revk/ESP32-ASR33/PCB/ASR33WAGO/README.md

# ASR33

Top
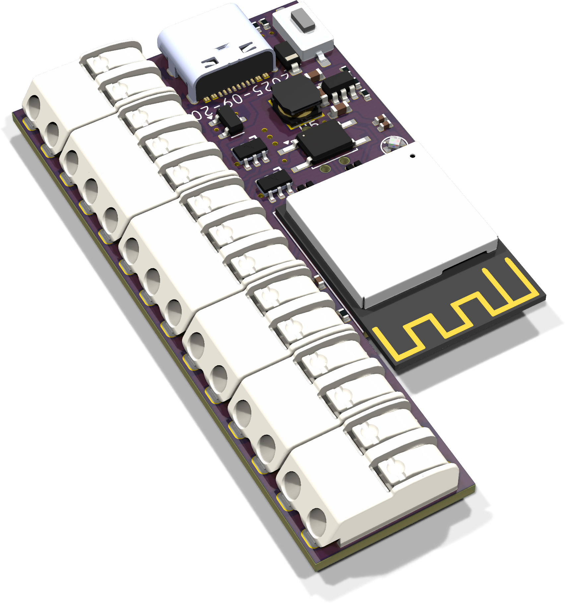
[picture p2: PCB/ASR33WAGO/ASR33-90.png]
Top rotated

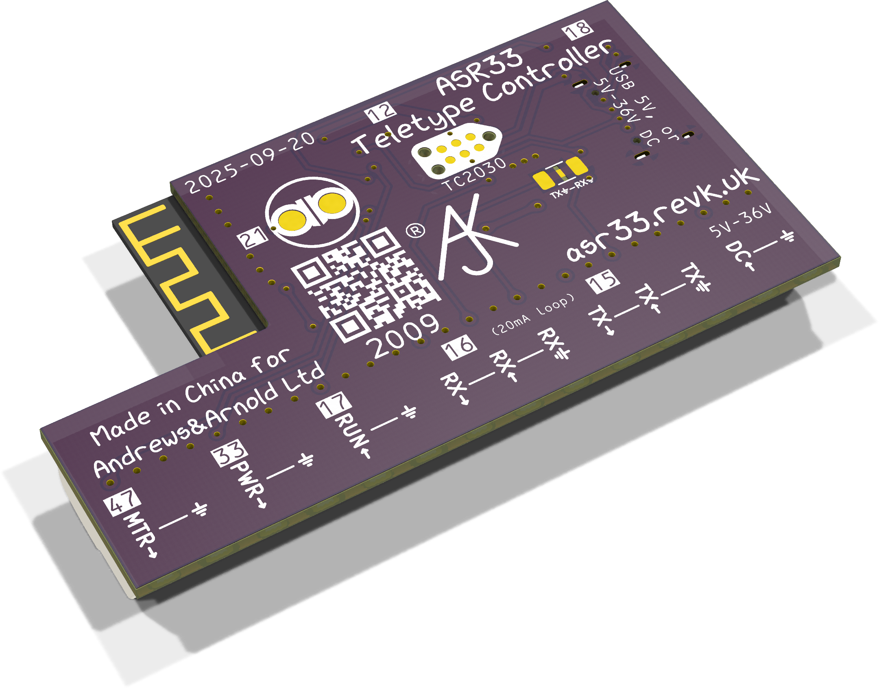
[picture p3: PCB/ASR33WAGO/ASR33-bottom.png]
Bottom
