revk/ESP32-ASR33/PCB/PCBOld/README.md

# ASR33Old

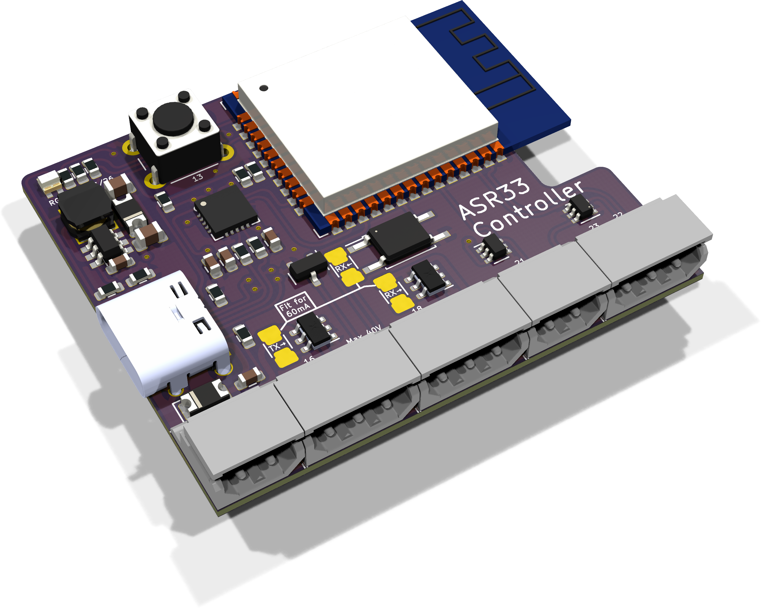
[picture p4: PCB/PCBOld/ASR33Old.png]
Top

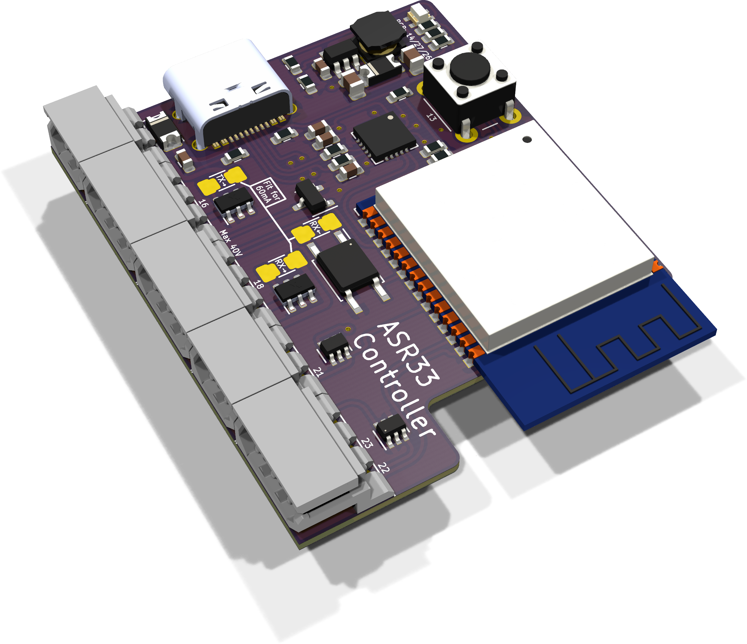
[picture p5: PCB/PCBOld/ASR33Old-90.png]
Top rotated

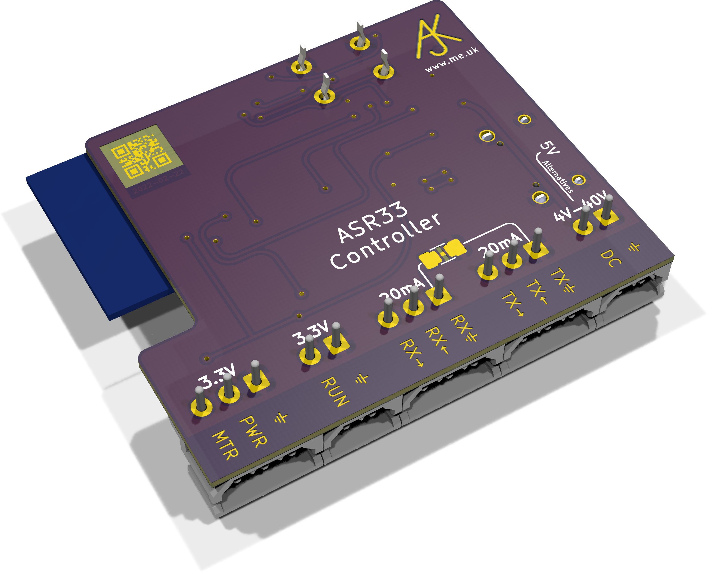
[picture p6: PCB/PCBOld/ASR33Old-bottom.png]
Bottom
