revk/ESP32-ASR33/PCB/ASR33/ASR33-90.png

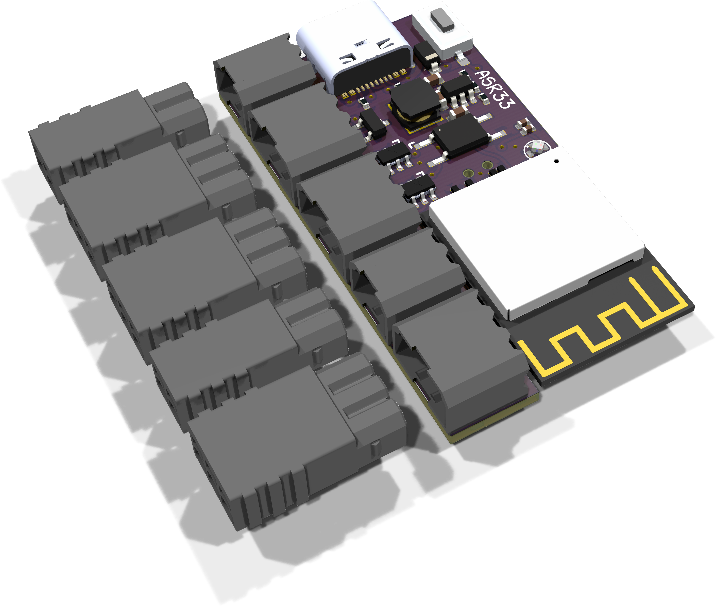
PCB/ASR33/ASR33-90.png
