revk/ESP32-ASR33/PCB/ASR33/ASR33-panel.png

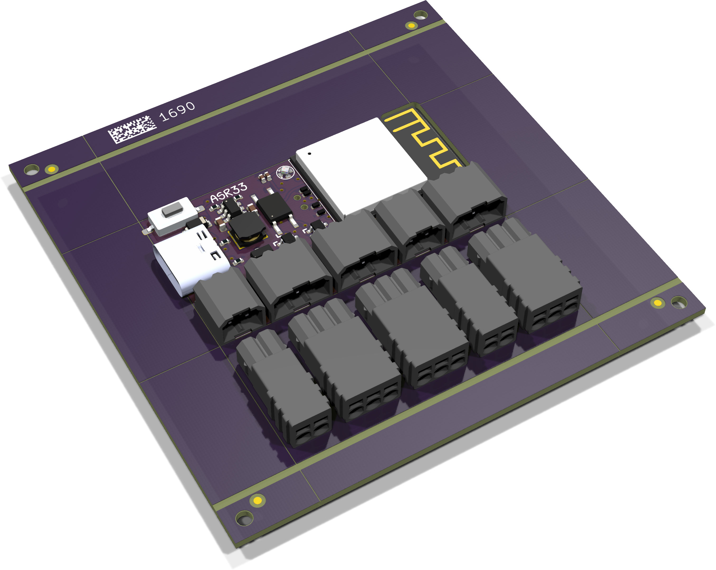
PCB/ASR33/ASR33-panel.png
