revk/ESP32-ASR33/PCB/ASR33WAGO/ASR33-panel-bottom.png

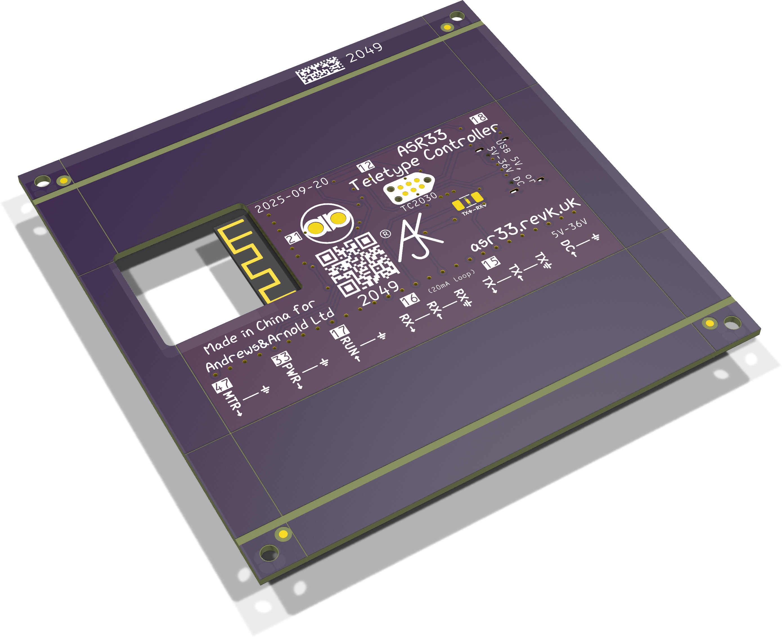
PCB/ASR33WAGO/ASR33-panel-bottom.png
