revk/ESP32-ASR33/PCB/ASR33WAGO/ASR33T.stl

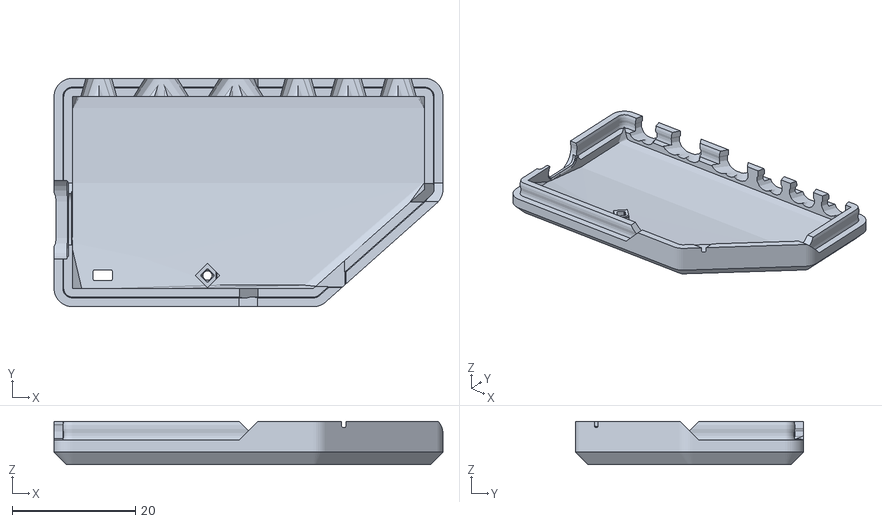
[picture p13: CAD file, 2025-09-20]
PCB/ASR33WAGO/ASR33T.stl
63.0 x 37.0 x 6.99
