revk/ESP32-ASR33/PCB/ASR33WAGO/ASR33B.stl

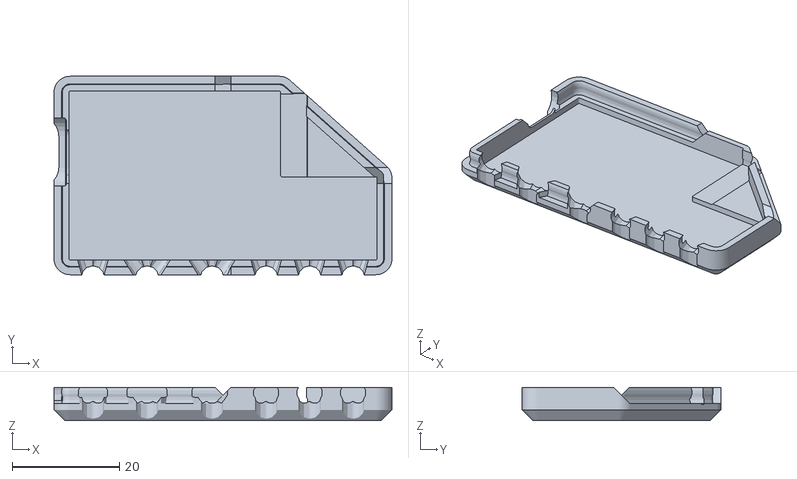
[picture p14: CAD file, 2025-09-20]
PCB/ASR33WAGO/ASR33B.stl
63.0 x 37.0 x 6.20
