revk/ESP32-ASR33/PCB/ASR33WAGO/ASR33B.scad

// Generated case design for ASR33WAGO/ASR33.kicad_pcb
// By https://github.com/revk/PCBCase
// Generated 2025-09-20 13:49:31
// title:	ASR33 driver
// rev:	1
// comment:	www.me.uk
// comment:	@TheRealRevK
//

// Globals
margin=0.250000;
lip=3.000000;
lipa=0;
lipt=2;
casebottom=2.000000;
casetop=7.000000;
casewall=3.000000;
fit=0.000000;
snap=0.150000;
edge=2.000000;
pcbthickness=1.200000;
function pcbthickness()=1.200000;
nohull=false;
hullcap=1.000000;
hulledge=1.000000;
useredge=false;
datex=0.000000;
datey=0.000000;
datet=0.500000;
dateh=3.000000;
datea=0;
date="2025-09-20";
datef="OCRB";
spacing=73.000000;
pcbwidth=57.000000;
function pcbwidth()=57.000000;
pcblength=31.000000;
function pcblength()=31.000000;
originx=100.500000;
originy=100.500000;

module outline(h=pcbthickness,r=0){linear_extrude(height=h)offset(r=r)polygon(points=[[10.500000,15.500000],[-28.500000,15.500000],[-28.500000,-15.500000],[28.500000,-15.500000],[28.500000,-0.500000],[11.000000,-0.500000],[10.808658,-0.461939],[10.646447,-0.353553],[10.538061,-0.191342],[10.500000,0.000000]],paths=[[0,1,2,3,4,5,6,7,8,9]]);}

module pcb(h=pcbthickness,r=0){linear_extrude(height=h)offset(r=r)polygon(points=[[10.500000,15.500000],[-28.500000,15.500000],[-28.500000,-15.500000],[28.500000,-15.500000],[28.500000,-0.500000],[11.000000,-0.500000],[10.808658,-0.461939],[10.646447,-0.353553],[10.538061,-0.191342],[10.500000,0.000000]],paths=[[0,1,2,3,4,5,6,7,8,9]]);}
module U4(){translate([-7.800000,1.300000,1.200000])children();}
module part_U4(part=true,hole=false,block=false)
{
// Missing model U4.1 SOT457
};
module V4(){translate([28.500000,0.500000,1.200000])rotate([0,0,90.000000])children();}
module part_V4(part=true,hole=false,block=false)
{
};
module R1(){translate([-15.500000,14.500000,1.200000])children();}
module part_R1(part=true,hole=false,block=false)
{
translate([-15.500000,14.500000,1.200000])m0(part,hole,block,casetop); // RevK:R_0402_ R_0402_1005Metric (back)
};
module C12(){translate([-15.500000,10.600000,1.200000])children();}
module part_C12(part=true,hole=false,block=false)
{
translate([-15.500000,10.600000,1.200000])m1(part,hole,block,casetop); // RevK:C_0603_ C_0603_1608Metric (back)
};
module C11(){translate([4.000000,-0.900000,1.200000])rotate([0,0,180.000000])children();}
module part_C11(part=true,hole=false,block=false)
{
translate([4.000000,-0.900000,1.200000])rotate([0,0,180.000000])m2(part,hole,block,casetop); // RevK:C_0402 C_0402_1005Metric (back)
};
module U5(){translate([-10.000000,7.850000,1.200000])rotate([0,0,90.000000])children();}
module part_U5(part=true,hole=false,block=false)
{
translate([-10.000000,7.850000,1.200000])rotate([0,0,90.000000])m3(part,hole,block,casetop); // U5 (back)
};
module J5(){translate([24.250000,-7.500000,1.200000])rotate([0,0,90.000000])children();}
module part_J5(part=true,hole=false,block=false)
{
translate([24.250000,-7.500000,1.200000])rotate([0,0,90.000000])m4(part,hole,block,casetop,452); // J5 (back)
};
module U3(){translate([-12.400000,1.300000,1.200000])children();}
module part_U3(part=true,hole=false,block=false)
{
// Missing model U3.1 SOT457
};
module J7(){translate([-22.000000,4.400000,1.200000])rotate([0,0,-90.000000])children();}
module part_J7(part=true,hole=false,block=false)
{
translate([-22.000000,4.400000,1.200000])rotate([0,0,-90.000000])translate([0.000000,-2.400000,0.000000])rotate([90.000000,-0.000000,-0.000000])m5(part,hole,block,casetop); // RevK:USB-C-Socket-H CSP-USC16-TR (back)
};
module R8(){translate([-27.000000,10.000000,1.200000])children();}
module part_R8(part=true,hole=false,block=false)
{
translate([-27.000000,10.000000,1.200000])m0(part,hole,block,casetop); // RevK:R_0402_ R_0402_1005Metric (back)
};
module D1(){translate([-21.500000,10.400000,1.200000])rotate([0,0,180.000000])children();}
module part_D1(part=true,hole=false,block=false)
{
translate([-21.500000,10.400000,1.200000])rotate([0,0,180.000000])m6(part,hole,block,casetop); // D1 (back)
};
module V3(){translate([-28.500000,0.500000,1.200000])rotate([0,0,90.000000])children();}
module part_V3(part=true,hole=false,block=false)
{
};
module D7(){translate([-6.000000,9.200000,1.200000])rotate([0,0,180.000000])children();}
module part_D7(part=true,hole=false,block=false)
{
translate([-6.000000,9.200000,1.200000])rotate([0,0,180.000000])m7(part,hole,block,casetop); // D7 (back)
};
module PCB1(){translate([-0.500000,0.500000,1.200000])children();}
module part_PCB1(part=true,hole=false,block=false)
{
};
module C10(){translate([-10.100000,14.000000,1.200000])rotate([0,0,90.000000])children();}
module part_C10(part=true,hole=false,block=false)
{
translate([-10.100000,14.000000,1.200000])rotate([0,0,90.000000])m2(part,hole,block,casetop); // RevK:C_0402 C_0402_1005Metric (back)
};
module R7(){translate([-27.000000,11.000000,1.200000])rotate([0,0,180.000000])children();}
module part_R7(part=true,hole=false,block=false)
{
translate([-27.000000,11.000000,1.200000])rotate([0,0,180.000000])m0(part,hole,block,casetop); // RevK:R_0402_ R_0402_1005Metric (back)
};
module R2(){translate([-13.700000,14.500000,1.200000])children();}
module part_R2(part=true,hole=false,block=false)
{
translate([-13.700000,14.500000,1.200000])m0(part,hole,block,casetop); // RevK:R_0402_ R_0402_1005Metric (back)
};
module U1(){translate([-15.500000,12.600000,1.200000])children();}
module part_U1(part=true,hole=false,block=false)
{
translate([-15.500000,12.600000,1.200000])m8(part,hole,block,casetop); // RevK:SOT-23-6-MD8942 SOT-23-6 (back)
};
module U8(){translate([2.750000,7.500000,1.200000])rotate([0,0,-90.000000])children();}
module part_U8(part=true,hole=false,block=false)
{
translate([2.750000,7.500000,1.200000])rotate([0,0,-90.000000])m9(part,hole,block,casetop); // U8 (back)
};
module L2(){translate([-15.500000,8.000000,1.200000])children();}
module part_L2(part=true,hole=false,block=false)
{
translate([-15.500000,8.000000,1.200000])rotate([-0.000000,-0.000000,-90.000000])m10(part,hole,block,casetop); // RevK:L_4x4_ TYA4020 (back)
};
module J9(){translate([-24.250000,-7.500000,1.200000])rotate([0,0,90.000000])children();}
module part_J9(part=true,hole=false,block=false)
{
translate([-24.250000,-7.500000,1.200000])rotate([0,0,90.000000])m4(part,hole,block,casetop,452); // J5 (back)
};
module R3(){translate([-17.300000,14.500000,1.200000])children();}
module part_R3(part=true,hole=false,block=false)
{
translate([-17.300000,14.500000,1.200000])m0(part,hole,block,casetop); // RevK:R_0402_ R_0402_1005Metric (back)
};
module Q1(){translate([-16.750000,1.537500,1.200000])rotate([0,0,90.000000])children();}
module part_Q1(part=true,hole=false,block=false)
{
translate([-16.750000,1.537500,1.200000])rotate([0,0,90.000000])m11(part,hole,block,casetop); // Q1 (back)
};
module J1(){translate([-14.150000,-7.500000,1.200000])rotate([0,0,90.000000])children();}
module part_J1(part=true,hole=false,block=false)
{
translate([-14.150000,-7.500000,1.200000])rotate([0,0,90.000000])m4(part,hole,block,casetop,453); // J5 (back)
};
module V1(){translate([-0.500000,15.500000,1.200000])children();}
module part_V1(part=true,hole=false,block=false)
{
};
module D2(){translate([-5.975000,8.350000,1.200000])rotate([0,0,180.000000])children();}
module part_D2(part=true,hole=false,block=false)
{
translate([-5.975000,8.350000,1.200000])rotate([0,0,180.000000])m7(part,hole,block,casetop); // D7 (back)
};
module D6(){translate([-6.000000,4.100000,1.200000])rotate([0,0,180.000000])children();}
module part_D6(part=true,hole=false,block=false)
{
translate([-6.000000,4.100000,1.200000])rotate([0,0,180.000000])m7(part,hole,block,casetop); // D7 (back)
};
module J2(){translate([-2.050000,-7.500000,1.200000])rotate([0,0,90.000000])children();}
module part_J2(part=true,hole=false,block=false)
{
translate([-2.050000,-7.500000,1.200000])rotate([0,0,90.000000])m4(part,hole,block,casetop,453); // J5 (back)
};
module R13(){translate([8.200000,-0.900000,1.200000])children();}
module part_R13(part=true,hole=false,block=false)
{
translate([8.200000,-0.900000,1.200000])m0(part,hole,block,casetop); // RevK:R_0402_ R_0402_1005Metric (back)
};
module V2(){translate([-0.500000,-15.500000,1.200000])rotate([0,0,180.000000])children();}
module part_V2(part=true,hole=false,block=false)
{
};
module C9(){translate([-9.200000,14.000000,1.200000])rotate([0,0,90.000000])children();}
module part_C9(part=true,hole=false,block=false)
{
translate([-9.200000,14.000000,1.200000])rotate([0,0,90.000000])m2(part,hole,block,casetop); // RevK:C_0402 C_0402_1005Metric (back)
};
module C8(){translate([-13.000000,11.300000,1.200000])rotate([0,0,90.000000])children();}
module part_C8(part=true,hole=false,block=false)
{
translate([-13.000000,11.300000,1.200000])rotate([0,0,90.000000])m1(part,hole,block,casetop); // RevK:C_0603_ C_0603_1608Metric (back)
};
module D4(){translate([-6.650000,13.450000,1.200000])rotate([0,0,45.000000])children();}
module part_D4(part=true,hole=false,block=false)
{
translate([-6.650000,13.450000,1.200000])rotate([0,0,45.000000])m12(part,hole,block,casetop); // RevK:SMD1010+ SMD1010 (back)
};
module SW1(){translate([-23.600000,13.400000,1.200000])children();}
module part_SW1(part=true,hole=false,block=false)
{
translate([-23.600000,13.400000,1.200000])m13(part,hole,block,casetop); // SW1 (back)
};
module J3(){translate([8.050000,-7.500000,1.200000])rotate([0,0,90.000000])children();}
module part_J3(part=true,hole=false,block=false)
{
translate([8.050000,-7.500000,1.200000])rotate([0,0,90.000000])m4(part,hole,block,casetop,452); // J5 (back)
};
module D3(){translate([-6.000000,3.200000,1.200000])rotate([0,0,180.000000])children();}
module part_D3(part=true,hole=false,block=false)
{
translate([-6.000000,3.200000,1.200000])rotate([0,0,180.000000])m7(part,hole,block,casetop); // D7 (back)
};
module J4(){translate([16.150000,-7.500000,1.200000])rotate([0,0,90.000000])children();}
module part_J4(part=true,hole=false,block=false)
{
translate([16.150000,-7.500000,1.200000])rotate([0,0,90.000000])m4(part,hole,block,casetop,452); // J5 (back)
};
module C1(){translate([-18.000000,11.300000,1.200000])rotate([0,0,90.000000])children();}
module part_C1(part=true,hole=false,block=false)
{
translate([-18.000000,11.300000,1.200000])rotate([0,0,90.000000])m1(part,hole,block,casetop); // RevK:C_0603_ C_0603_1608Metric (back)
};
// Parts to go on PCB (top)
module parts_top(part=false,hole=false,block=false){
part_U4(part,hole,block);
part_V4(part,hole,block);
part_R1(part,hole,block);
part_C12(part,hole,block);
part_C11(part,hole,block);
part_U5(part,hole,block);
part_J5(part,hole,block);
part_U3(part,hole,block);
part_J7(part,hole,block);
part_R8(part,hole,block);
part_D1(part,hole,block);
part_V3(part,hole,block);
part_D7(part,hole,block);
part_PCB1(part,hole,block);
part_C10(part,hole,block);
part_R7(part,hole,block);
part_R2(part,hole,block);
part_U1(part,hole,block);
part_U8(part,hole,block);
part_L2(part,hole,block);
part_J9(part,hole,block);
part_R3(part,hole,block);
part_Q1(part,hole,block);
part_J1(part,hole,block);
part_V1(part,hole,block);
part_D2(part,hole,block);
part_D6(part,hole,block);
part_J2(part,hole,block);
part_R13(part,hole,block);
part_V2(part,hole,block);
part_C9(part,hole,block);
part_C8(part,hole,block);
part_D4(part,hole,block);
part_SW1(part,hole,block);
part_J3(part,hole,block);
part_D3(part,hole,block);
part_J4(part,hole,block);
part_C1(part,hole,block);
}

parts_top=15;
module J8(){translate([-10.000000,7.485000,0.000000])rotate([180,0,0])children();}
module part_J8(part=true,hole=false,block=false)
{
};
module JP1(){translate([-15.200000,1.600000,0.000000])rotate([180,0,0])children();}
module part_JP1(part=true,hole=false,block=false)
{
};
module J6(){translate([2.750000,7.500000,0.000000])rotate([0,0,180.000000])rotate([180,0,0])children();}
module part_J6(part=true,hole=false,block=false)
{
};
// Parts to go on PCB (bottom)
module parts_bottom(part=false,hole=false,block=false){
part_J8(part,hole,block);
part_JP1(part,hole,block);
part_J6(part,hole,block);
}

parts_bottom=0;
module b(cx,cy,z,w,l,h){translate([cx-w/2,cy-l/2,z])cube([w,l,h]);}
module m0(part=false,hole=false,block=false,height)
{ // RevK:R_0402_ R_0402_1005Metric
// 0402 Resistor
if(part)
{
	b(0,0,0,1.5,0.65,0.2); // Pad size
	b(0,0,0,1.0,0.5,0.5); // Chip
}
}

module m1(part=false,hole=false,block=false,height)
{ // RevK:C_0603_ C_0603_1608Metric
// 0603 Capacitor
if(part)
{
	b(0,0,0,1.6,0.8,1); // Chip
	b(0,0,0,1.6,0.95,0.2); // Pad size
}
}

module m2(part=false,hole=false,block=false,height)
{ // RevK:C_0402 C_0402_1005Metric
// 0402 Capacitor
if(part)
{
	b(0,0,0,1.0,0.5,1); // Chip
	b(0,0,0,1.5,0.65,0.2); // Pad size
}
}

module m3(part=false,hole=false,block=false,height)
{ // U5
// SO-4_4.4x3.6mm_P2.54mm 
if(part)
{
	b(0,0,0,4.55,3.75,2.1); // Part
	b(0,0,0,7.0,3,1.5); // Pins
}
}

module m4(part=false,hole=false,block=false,height,N=0)
{ // J5
// WAGO-2060-45x-998-404
n=N%10; // 45x
if(part)
{
	translate([-0.9,0,0])hull()
	{
		b(0,0,0,12.7,n*4-0.1,1);
		translate([0.8,0,0])b(0,0,0,11.1,n*4-0.1,4.5);
	}
	for(p=[0:n-1])hull()
    {
        translate([-6,-4*(n-1)/2+p*4,2])sphere(d=3,$fn=12);
        translate([-11.510,0,2])sphere(d=4,$fn=12);
    }
}
if(hole)
{
    hull()
    {
        translate([-11.510,0,2])sphere(d=4,$fn=12);
        translate([-11.510,0,-height])sphere(d=4,$fn=12);
    }
    hull()
    {
        translate([-11.510,0,2])sphere(d=4,$fn=12);
        translate([-50,0,2])sphere(d=4,$fn=12);
    }
}
}

module m5(part=false,hole=false,block=false,height)
{ // RevK:USB-C-Socket-H CSP-USC16-TR
// USB connector
rotate([-90,0,0])translate([-4.47,-3.84,0])
{
	if(part)
	{
		b(4.47,7,0,7,2,0.2);	// Pads
		translate([1.63,-0.2,1.63])
		rotate([-90,0,0])
		hull()
		{
			cylinder(d=3.26,h=7.55,$fn=24);
			translate([5.68,0,0])
			cylinder(d=3.26,h=7.55,$fn=24);
		}
		translate([0,6.2501,0])cube([8.94,1.1,1.6301]);
		translate([0,1.7,0])cube([8.94,1.6,1.6301]);
	}
	if(hole)
		translate([1.63,-21.2-1,1.63])
		rotate([-90,0,0])
	{
		// Plug
		hull()
		{
			cylinder(d=2.5,h=24,$fn=24);
			translate([5.68,0,0])
			cylinder(d=2.5,h=24,$fn=24);
		}
		hull()
		{
			cylinder(d=7,h=21,$fn=24);
			translate([5.68,0,0])
			cylinder(d=7,h=21,$fn=24);
		}
		translate([2.84,0,-100])
			cylinder(d=5,h=100,$fn=24);
	}
}
}

module m6(part=false,hole=false,block=false,height)
{ // D1
// SOD-123 Diode
if(part)
{
	b(0,0,0,2.85,1.8,1.35); // part
	b(0,0,0,4.2,1.2,0.7); // pads
}
}

module m7(part=false,hole=false,block=false,height)
{ // D7
// DFN1006-2L
if(part)
{
	b(0,0,0,1.0,0.6,0.45); // Chip
}
}

module m8(part=false,hole=false,block=false,height)
{ // RevK:SOT-23-6-MD8942 SOT-23-6
// SOT-23-6
if(part)
{
	b(0,0,0,1.726,3.026,1.2); // Part
	b(0,0,0,3.6,2.5,0.5); // Pins
}
}

module m9(part=false,hole=false,block=false,height)
{ // U8
// ESP32-S3-MINI-1
translate([-15.4/2,-15.45/2,0])
{
	if(part)
	{
		cube([15.4,20.5,0.8]);
		translate([0.7,0.5,0])cube([14,13.55,2.4]);
		cube([15.4,20.5,0.8]);
	}
}
}

module m10(part=false,hole=false,block=false,height)
{ // RevK:L_4x4_ TYA4020
// 4x4 Inductor
if(part)
{
	b(0,0,0,4,4,3);
}
}

module m11(part=false,hole=false,block=false,height)
{ // Q1
// SOT-23
if(part)
{
	b(0,0,0,1.4,3.0,1.1); // Body
	b(-0.9375,-0.95,0,1.475,0.6,0.5); // Pad
	b(-0.9375,0.95,0,1.475,0.6,0.5); // Pad
	b(0.9375,0,0,1.475,0.6,0.5); // Pad
}
}

module m12(part=false,hole=false,block=false,height)
{ // RevK:SMD1010+ SMD1010
// 1x1mm LED
if(part)
{
        b(0,0,0,1.2,1.2,.8);
}
if(hole)
{
        hull()
        {
                b(0,0,.8,1.2,1.2,1);
                translate([0,0,height])cylinder(d=1.001,h=0.001,$fn=16);
        }
}
if(block)
{
        hull()
        {
                b(0,0,.8,2.8,2.8,1);
                translate([0,0,height])cylinder(d=2,h=1,$fn=16);
        }
}
}

module m13(part=false,hole=false,block=false,height)
{ // SW1
if(part)
{
	b(0,0,0,6.1,3.6,1.8);
	b(0,0,0,7.9,0.6,0.5);
}
if(hole)
{
	b(0,0,0,2.65,1.25,height+1);
}
}

// Generate PCB casework

height=casebottom+pcbthickness+casetop;
$fn=48;

module pyramid()
{ // A pyramid
 polyhedron(points=[[0,0,0],[-height,-height,height],[-height,height,height],[height,height,height],[height,-height,height]],faces=[[0,1,2],[0,2,3],[0,3,4],[0,4,1],[4,3,2,1]]);
}


module pcb_hulled(h=pcbthickness,r=0)
{ // PCB shape for case
	if(useredge)outline(h,r);
	else hull()outline(h,r);
}

module solid_case(d=0)
{ // The case wall
	hull()
        {
                translate([0,0,-casebottom])pcb_hulled(height,casewall-edge);
                translate([0,0,edge-casebottom])pcb_hulled(height-edge*2,casewall);
        }
}

module preview()
{
	pcb();
	color("#0f0")parts_top(part=true);
	color("#0f0")parts_bottom(part=true);
	color("#f00")parts_top(hole=true);
	color("#f00")parts_bottom(hole=true);
	color("#00f8")parts_top(block=true);
	color("#00f8")parts_bottom(block=true);
}

module top_half(fit=0)
{
	difference()
	{
		translate([-casebottom-100,-casewall-100,pcbthickness+0.01]) cube([pcbwidth+casewall*2+200,pcblength+casewall*2+200,height]);
		translate([0,0,pcbthickness])
        	{
			snape=lip/5;
			snaph=(lip-snape*2)/3;
			if(lipt==1)rotate(lipa)hull()
			{
				translate([0,-pcblength,lip/2])cube([0.001,pcblength*2,0.001]);
				translate([-lip/2,-pcblength,0])cube([lip,pcblength*2,0.001]);
			} else if(lipt==2)for(a=[0,90,180,270])rotate(a+lipa)hull()
			{
				translate([0,-pcblength-pcbwidth,lip/2])cube([0.001,pcblength*2+pcbwidth*2,0.001]);
				translate([-lip/2,-pcblength-pcbwidth,0])cube([lip,pcblength*2+pcbwidth*2,0.001]);
			}
            		difference()
            		{
                		pcb_hulled(lip,casewall);
				if(snap)
                        	{
					hull()
					{
						pcb_hulled(0.1,casewall/2-snap/2+fit);
						translate([0,0,snape])pcb_hulled(snaph,casewall/2+snap/2+fit);
						translate([0,0,lip-snape-snaph])pcb_hulled(0.1,casewall/2-snap/2+fit);
					}
					translate([0,0,lip-snape-snaph])pcb_hulled(snaph,casewall/2-snap/2+fit);
					hull()
					{
						translate([0,0,lip-snape])pcb_hulled(0.1,casewall/2-snap/2+fit);
						translate([0,0,lip])pcb_hulled(0.1,casewall/2+snap/2+fit);
					}
                        	}
				else pcb_hulled(lip,casewall/2+fit);
				if(lipt==0)translate([-pcbwidth,-pcblength,0])cube([pcbwidth*2,pcblength*2,lip]);
				else if(lipt==1) rotate(lipa)translate([0,-pcblength,0])hull()
				{
					translate([lip/2,0,0])cube([pcbwidth,pcblength*2,lip]);
					translate([-lip/2,0,lip])cube([pcbwidth,pcblength*2,lip]);
				}
				else if(lipt==2)for(a=[0,180])rotate(a+lipa)hull()
                		{
                            		translate([lip/2,lip/2,0])cube([pcbwidth+pcblength,pcbwidth+pcblength,lip]);
                            		translate([-lip/2,-lip/2,lip])cube([pcbwidth+pcblength,pcbwidth+pcblength,lip]);
                		}
            		}
            		difference()
            		{
				if(snap)
                        	{
					hull()
					{
						translate([0,0,-0.1])pcb_hulled(0.1,casewall/2+snap/2-fit);
						translate([0,0,snape-0.1])pcb_hulled(0.1,casewall/2-snap/2-fit);
					}
					translate([0,0,snape])pcb_hulled(snaph,casewall/2-snap/2-fit);
					hull()
					{
						translate([0,0,snape+snaph])pcb_hulled(0.1,casewall/2-snap/2-fit);
						translate([0,0,lip-snape-snaph])pcb_hulled(snaph,casewall/2+snap/2-fit);
						translate([0,0,lip-0.1])pcb_hulled(0.1,casewall/2-snap/2-fit);
					}
                        	}
				else pcb_hulled(lip,casewall/2-fit);
				if(lipt==1)rotate(lipa+180)translate([0,-pcblength,0])hull()
				{
					translate([lip/2,0,0])cube([pcbwidth,pcblength*2,lip+0.1]);
					translate([-lip/2,0,lip])cube([pcbwidth,pcblength*2,lip+0.1]);
				}
				else if(lipt==2)for(a=[90,270])rotate(a+lipa)hull()
                		{
                            		translate([lip/2,lip/2,0])cube([pcbwidth+pcblength,pcbwidth+pcblength,lip]);
                            		translate([-lip/2,-lip/2,lip])cube([pcbwidth+pcblength,pcbwidth+pcblength,lip]);
                		}
			}
            	}
		minkowski()
                {
                	union()
                	{
                		parts_top(part=true,hole=true);
                		parts_bottom(part=true,hole=true);
                	}
                	translate([-0.01,-0.01,-height])cube([0.02,0.02,height]);
                }
        }
	minkowski()
        {
        	union()
                {
                	parts_top(part=true,hole=true);
                	parts_bottom(part=true,hole=true);
                }
                translate([-0.01,-0.01,0])cube([0.02,0.02,height]);
        }
}

module case_wall()
{
	difference()
	{
		solid_case();
		translate([0,0,-height])pcb_hulled(height*2,0.02);
	}
}

module top_side_hole()
{
	difference()
	{
		intersection()
		{
			parts_top(hole=true);
			case_wall();
		}
		translate([0,0,-casebottom])pcb_hulled(height,casewall);
	}
}

module bottom_side_hole()
{
	difference()
	{
		intersection()
		{
			parts_bottom(hole=true);
			case_wall();
		}
		translate([0,0,edge-casebottom])pcb_hulled(height-edge*2,casewall);
	}
}

module parts_space()
{
	minkowski()
	{
		union()
		{
			parts_top(part=true,hole=true);
			parts_bottom(part=true,hole=true);
		}
		sphere(r=margin,$fn=6);
	}
}

module top_cut(fit=0)
{
	difference()
	{
		top_half(fit);
		if(parts_top)difference()
		{
			minkowski()
			{ // Penetrating side holes
				top_side_hole();
				rotate([180,0,0])
				pyramid();
			}
			minkowski()
			{
				top_side_hole();
				rotate([0,0,45])cylinder(r=margin,h=height,$fn=4);
			}
		}
	}
	if(parts_bottom)difference()
	{
		minkowski()
		{ // Penetrating side holes
			bottom_side_hole();
			pyramid();
		}
			minkowski()
			{
				bottom_side_hole();
				rotate([0,0,45])translate([0,0,-height])cylinder(r=margin,h=height,$fn=4);
			}
	}
}

module bottom_cut()
{
	difference()
	{
		 translate([-casebottom-50,-casewall-50,-height]) cube([pcbwidth+casewall*2+100,pcblength+casewall*2+100,height*2]);
		 top_cut(-fit);
	}
}

module top_body()
{
	difference()
	{
		intersection()
		{
			solid_case();
			pcb_hulled(casetop+pcbthickness,0.03);
		}
		if(parts_top)minkowski()
		{
			if(nohull)parts_top(part=true);
			else hull(){parts_top(part=true);pcb_hulled();}
			translate([0,0,margin-height])cylinder(r=margin*2,h=height,$fn=8);
		}
	}
	intersection()
	{
		pcb_hulled(casetop+pcbthickness,0.03);
		union()
		{
			parts_top(block=true);
			parts_bottom(block=true);
		}
	}
}

module top_edge()
{
	intersection()
	{
		case_wall();
		top_cut();
	}
}

module top_pos()
{ // Position for plotting bottom
	translate([0,0,pcbthickness+casetop])rotate([180,0,0])children();
}

module pcb_pos()
{	// Position PCB relative to base 
		translate([0,0,pcbthickness-height])children();
}

module top()
{
	top_pos()difference()
	{
		union()
		{
			top_body();
			top_edge();
		}
		parts_space();
		pcb_pos()pcb(height,r=margin);
	}
}

module bottom_body()
{ // Position for plotting top
	difference()
	{
		intersection()
		{
			solid_case();
			translate([0,0,-casebottom])pcb_hulled(casebottom+pcbthickness,0.03);
		}
		if(parts_bottom)minkowski()
		{
			if(nohull)parts_bottom(part=true);
			else hull()parts_bottom(part=true);
			translate([0,0,-margin])cylinder(r=margin*2,h=height,$fn=8);
		}
	}
	intersection()
	{
		translate([0,0,-casebottom])pcb_hulled(casebottom+pcbthickness,0.03);
		union()
		{
			parts_top(block=true);
			parts_bottom(block=true);
		}
	}
}

module bottom_edge()
{
	intersection()
	{
		case_wall();
		bottom_cut();
	}
}

module bottom_pos()
{
	translate([0,0,casebottom])children();
}

module bottom()
{
	bottom_pos()difference()
	{
		union()
		{
        		bottom_body();
        		bottom_edge();
		}
		parts_space();
		pcb(height,r=margin);
	}
}

module datecode()
{
	minkowski()
	{
		translate([datex,datey,-1])rotate(datea)scale([-1,1])linear_extrude(1)text(date,size=dateh,halign="center",valign="center",font=datef);
		cylinder(d1=datet,d2=0,h=datet,$fn=6);
	}
}
difference(){bottom();datecode();}
