revk/ESP32-ASR33/(list of files, cad)

Other CAD files:
PCB/ASR33WAGO/ASR33T.scad
