revk/ESP32-ASR33/Manuals/ASR33.png

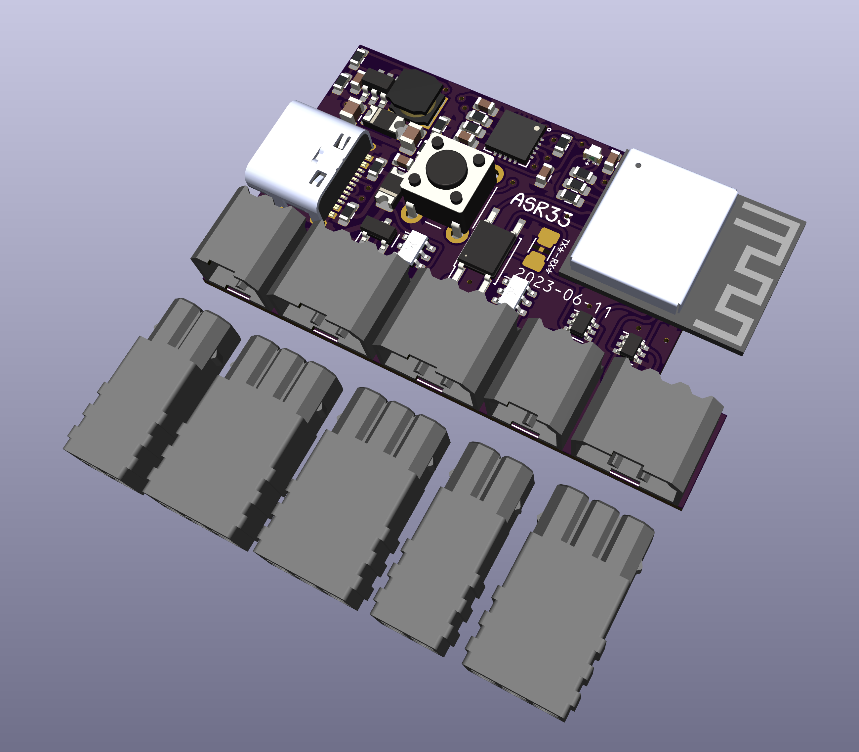
Manuals/ASR33.png
