revk/ESP32-ASR33/Manuals/ASR33b.png

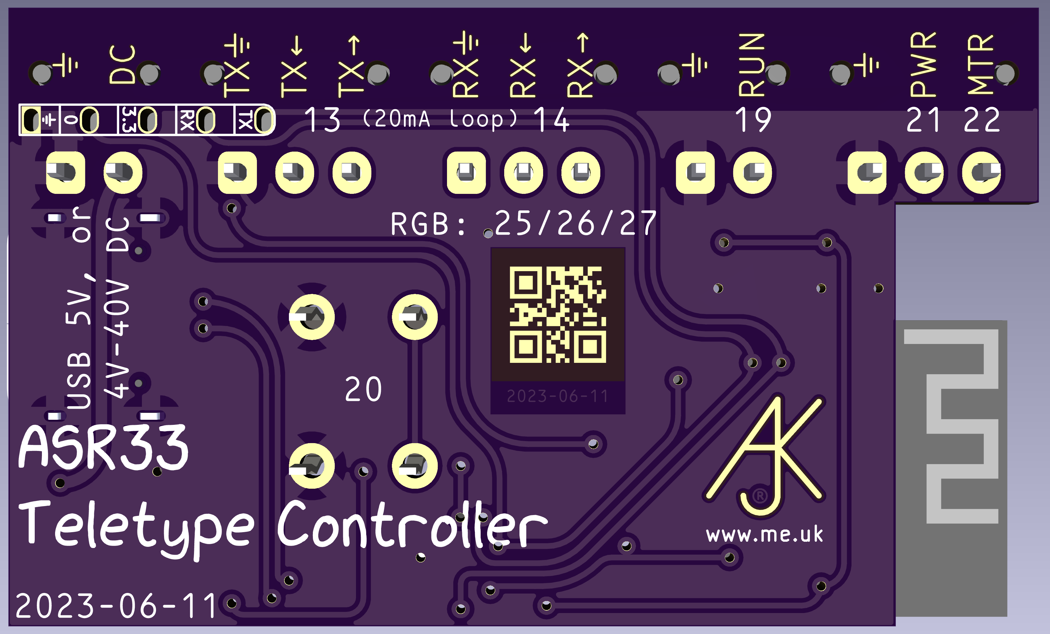
Manuals/ASR33b.png
