revk/ESP32-ASR33/PCB/ASR33WAGO/ASR33.kicad_pcb

## KiCad design PCB/ASR33WAGO/ASR33.kicad_pcb (2025-09-20)

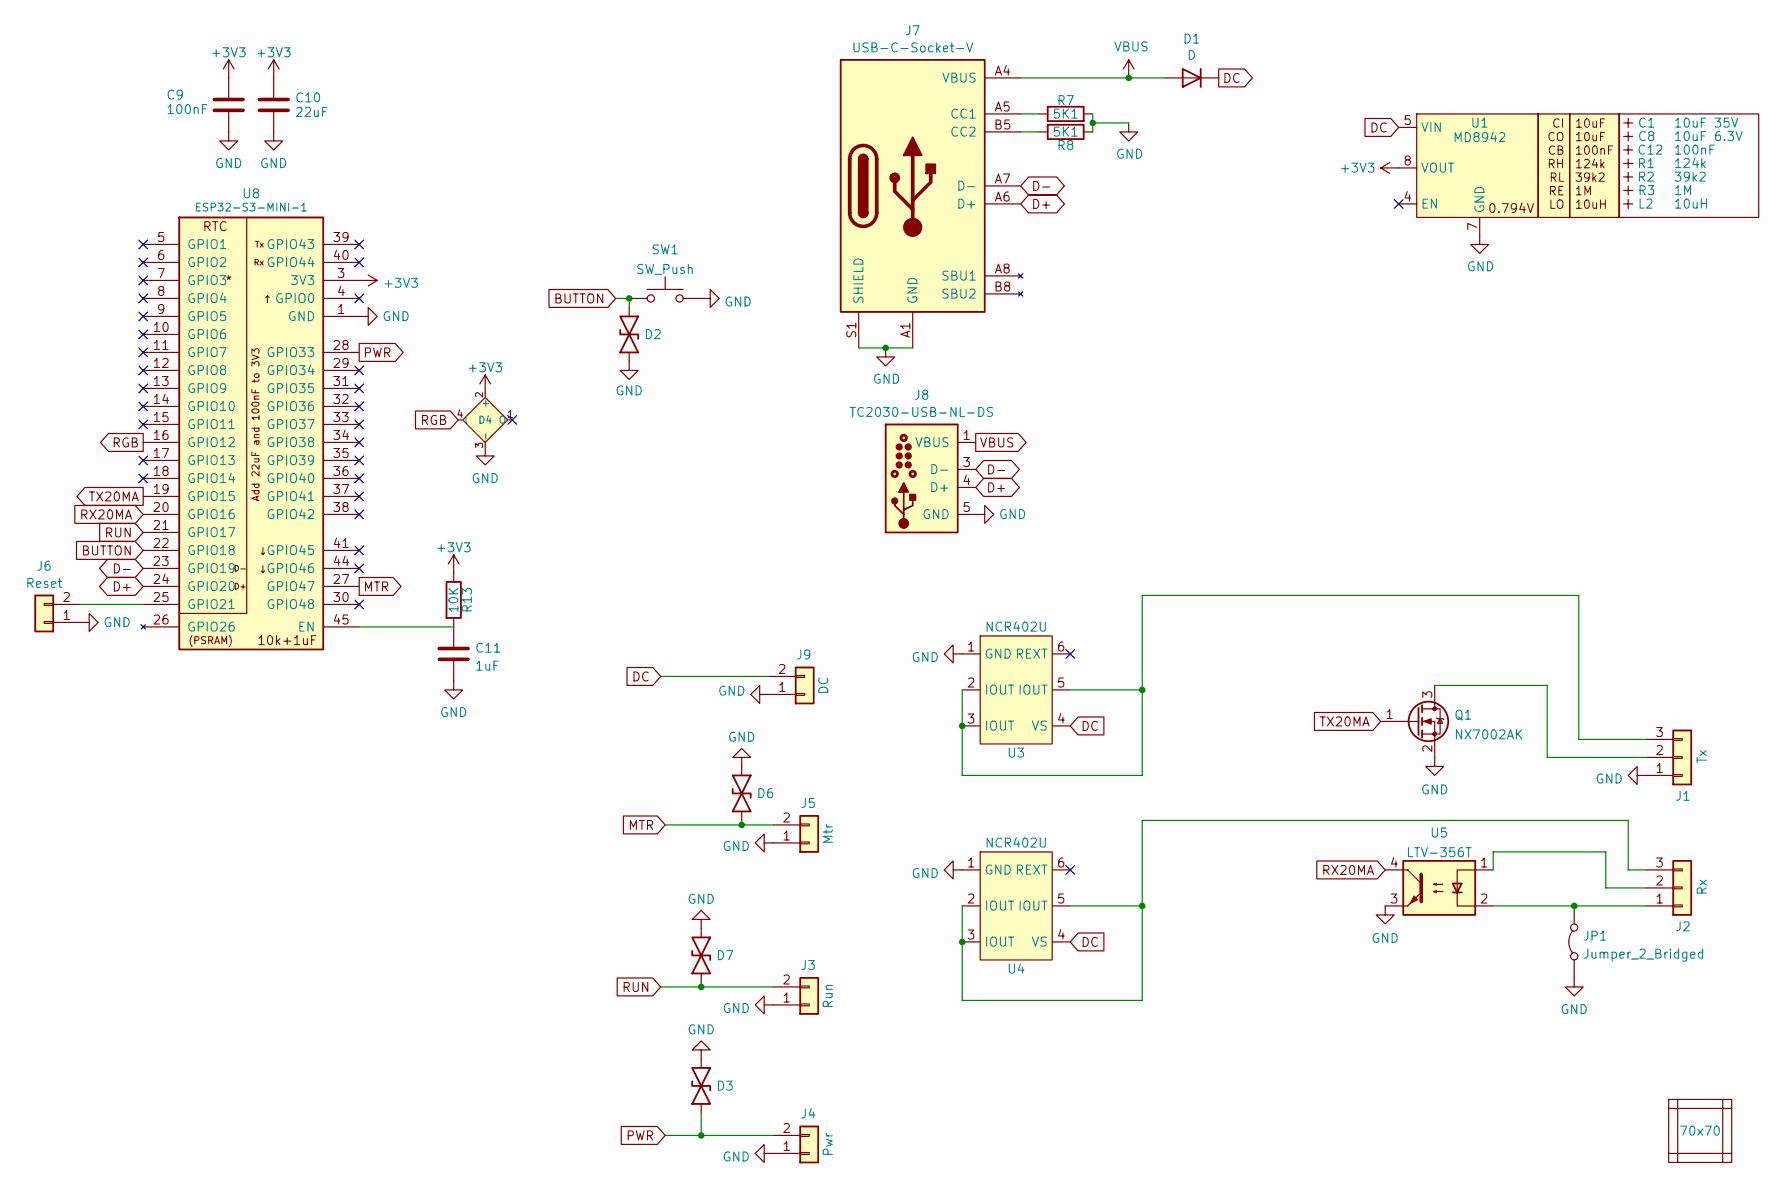
[picture p19: schematic ASR33.kicad_sch, ASR33 controller]

Parts:
C1: 10uF 35V; C_0603_; MPN C194427
C8: 10uF 6.3V; C_0603_; MPN C1691
C9: 100nF; C_0402
C10: 22uF; C_0402
C11: 1uF; C_0402
C12: 100nF; C_0603_
D1: D; D_SOD-123; MPN C1884542
D2, D3, D6, D7: DFN1006-2L; MPN C5137770
D4: XL-1010RGBC-WS2812B; SMD1010+; MPN C5349953
J1: Tx; WAGO-2060-453-998-404; MPN C2765056
J2: Rx; WAGO-2060-453-998-404; MPN C2765056
J3: Run; WAGO-2060-452-998-404; MPN C2765055
J4: Pwr; WAGO-2060-452-998-404; MPN C2765055
J5: Mtr; WAGO-2060-452-998-404; MPN C2765055
J6: Reset; AA-Pad
J7: USB-C-Socket-V; USB-C-Socket-H; MPN C709357
J8: TC2030-USB-NL-DS; Tag-Connect_TC2030-IDC-NL_2x03_P1.27mm_Vertical
J9: DC; WAGO-2060-452-998-404; MPN C2765055
JP1: Jumper_2_Bridged; Pad_1206_0805_Bridged
L2: 10uH; L_4x4_
PCB1: 70x70; PCB7070
Q1: NX7002AK; SOT-23
R1: 124k; R_0402_; MPN C138062
R2: 39k2; R_0402_
R3: 1M; R_0402_
R7, R8: 5K1; R_0402
R13: 10K; R_0402
SW1: SW_Push; TS-1092S-B3D2-G
U1: MD8942; SOT-23-6-MD8942; MPN C2684786
U3, U4: NCR402U; SOT-457; MPN C458148
U5: LTV-356T; SO-4_4.4x3.6mm_P2.54mm
U8: ESP32-S3-MINI-1; MPN C3013941
V1, V2, V3, V4: VCUT70N

Connections:
+3V3: C9.1, C10.1, D4.2 (+), R13.1, U1.8 (VOUT), U8.3 (3V3)
BUTTON: D2.1, SW1.2, U8.22 (GPIO18)
D+: J7.A6 (D+), J7.B6 (D+), J8.4 (D+), U8.24 (GPIO20)
D-: J7.A7 (D-), J7.B7 (D-), J8.3 (D-), U8.23 (GPIO19)
DC: D1.1 (K), J9.2, U1.5 (VIN), U3.4 (VS), U4.4 (VS)
GND: C9.2, C10.2, C11.2, D2.2, D3.2, D4.3 (-), D6.2, D7.2, J1.1, J3.1, J4.1, J5.1, J6.1, J7.A1 (GND), J7.A12 (GND), J7.B1 (GND), J7.B12 (GND), J7.S1 (SHIELD), J8.5 (GND), J8.6 (GND), J9.1, JP1.1 (A), Q1.2 (S), R7.2, R8.1, SW1.1, U1.2 (GND), U1.7 (GND), U3.1 (GND), U4.1 (GND), U5.3, U8.1 (GND), U8.2 (GND), U8.42 (GND), U8.43 (GND), U8.46 (GND), U8.47 (GND), U8.48 (GND), U8.49 (GND), U8.50 (GND), U8.51 (GND), U8.52 (GND), U8.53 (GND), U8.54 (GND), U8.55 (GND), U8.56 (GND), U8.57 (GND), U8.58 (GND), U8.59 (GND), U8.60 (GND), U8.61 (GND), U8.62 (GND), U8.63 (GND), U8.64 (GND), U8.65 (GND)
MTR: D6.1, J5.2, U8.27 (GPIO47)
unnamed: J1.2, Q1.3 (D)
unnamed: J1.3, U3.2 (IOUT), U3.3 (IOUT), U3.5 (IOUT)
unnamed: J2.1, JP1.2 (B), U5.2
unnamed: J2.2, U5.1
unnamed: J2.3, U4.2 (IOUT), U4.3 (IOUT), U4.5 (IOUT)
unnamed: J6.2, U8.25 (GPIO21)
unnamed: J7.A5 (CC1), R7.1
unnamed: J7.B5 (CC2), R8.2
unnamed: C11.1, R13.2, U8.45 (EN)
PWR: D3.1, J4.2, U8.28 (GPIO33)
RGB: D4.4 (I), U8.16 (GPIO12)
RUN: D7.1, J3.2, U8.21 (GPIO17)
RX20MA: U5.4, U8.20 (GPIO16)
TX20MA: Q1.1 (G), U8.19 (GPIO15)
VBUS: D1.2 (A), J7.A4 (VBUS), J7.A9 (VBUS), J7.B4 (VBUS), J7.B9 (VBUS), J8.1 (VBUS), J8.2 (VBUS)

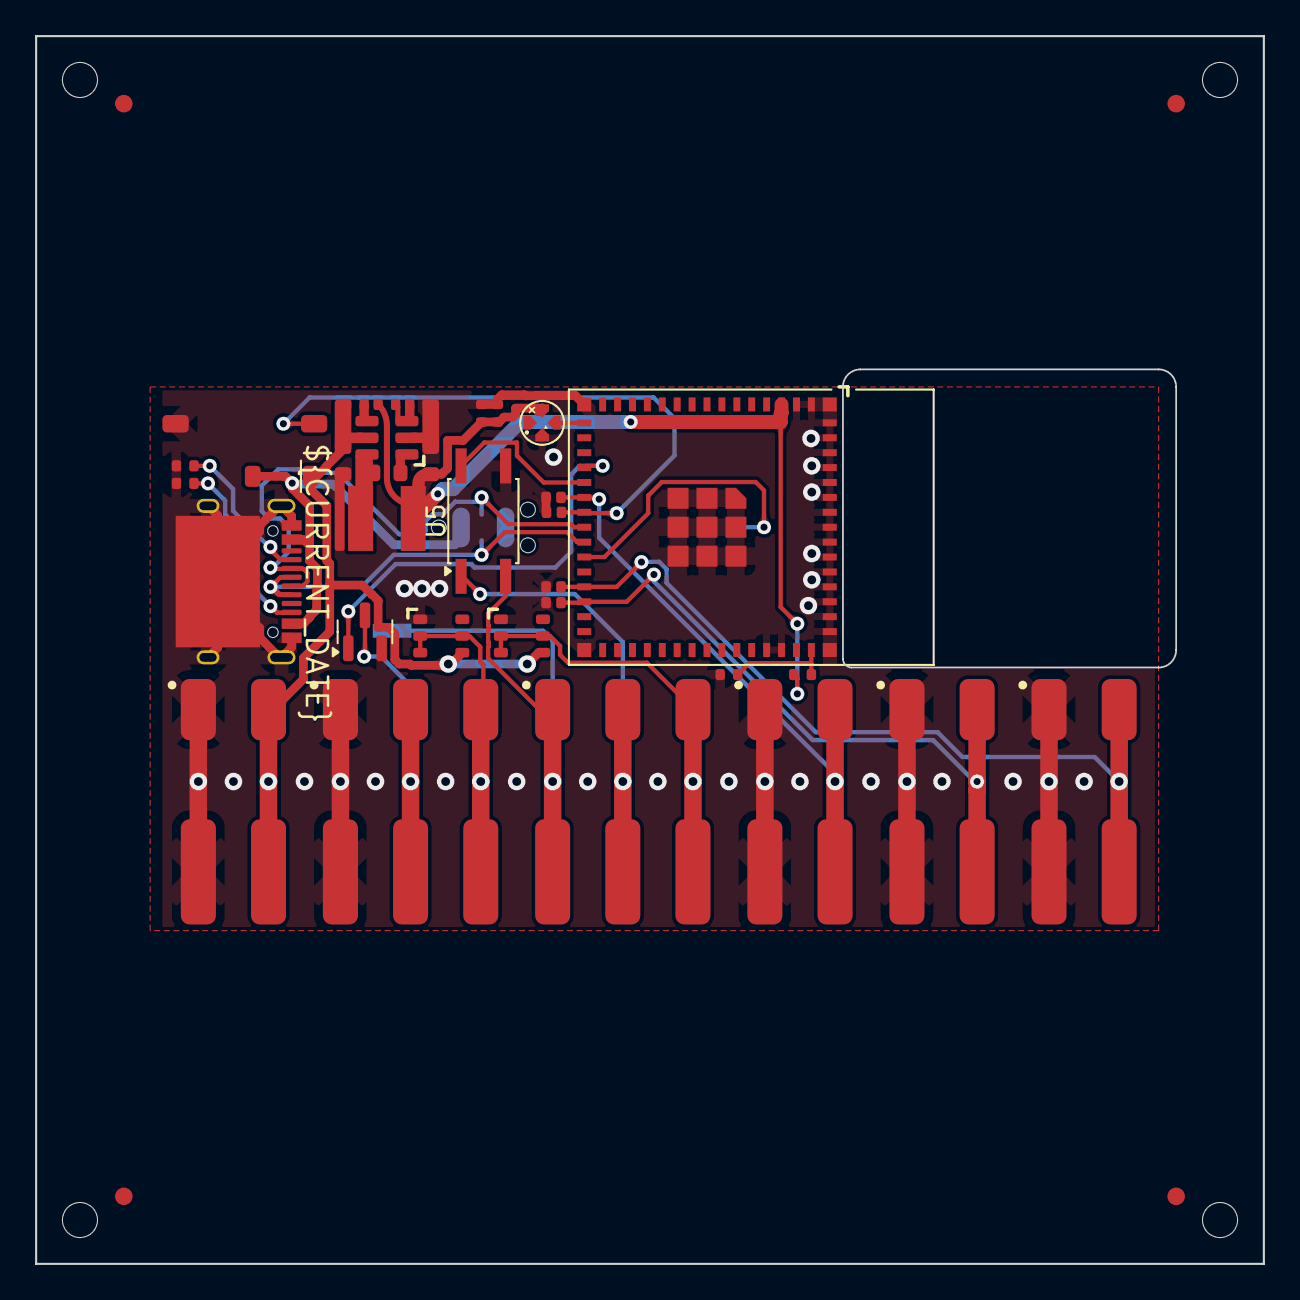
[picture p20: board ASR33.kicad_pcb from above]

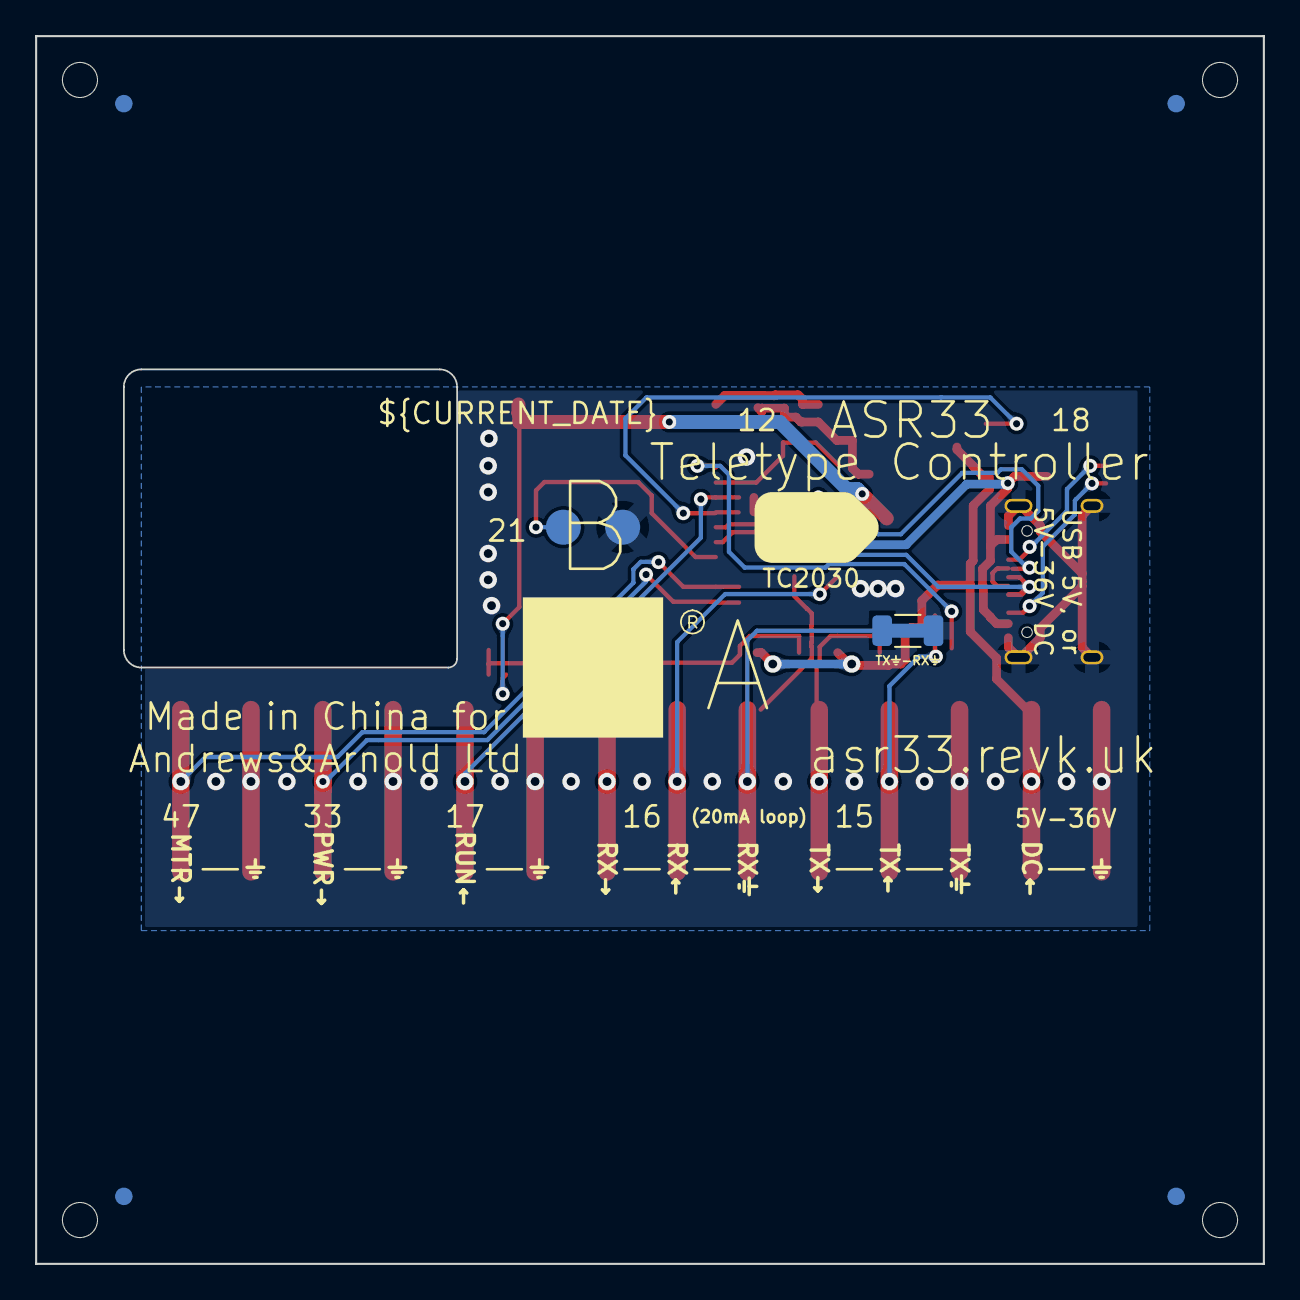
[picture p21: board ASR33.kicad_pcb from below]

Board: 2 copper layers, 70.0 x 70.0 mm, 41 parts (3 on the bottom side), 22 nets.
