revk/ESP32-ASR33/PCB/PCBOld/ASR33Old.kicad_pcb

## KiCad design PCB/PCBOld/ASR33Old.kicad_pcb (2022-06-22, an earlier design)

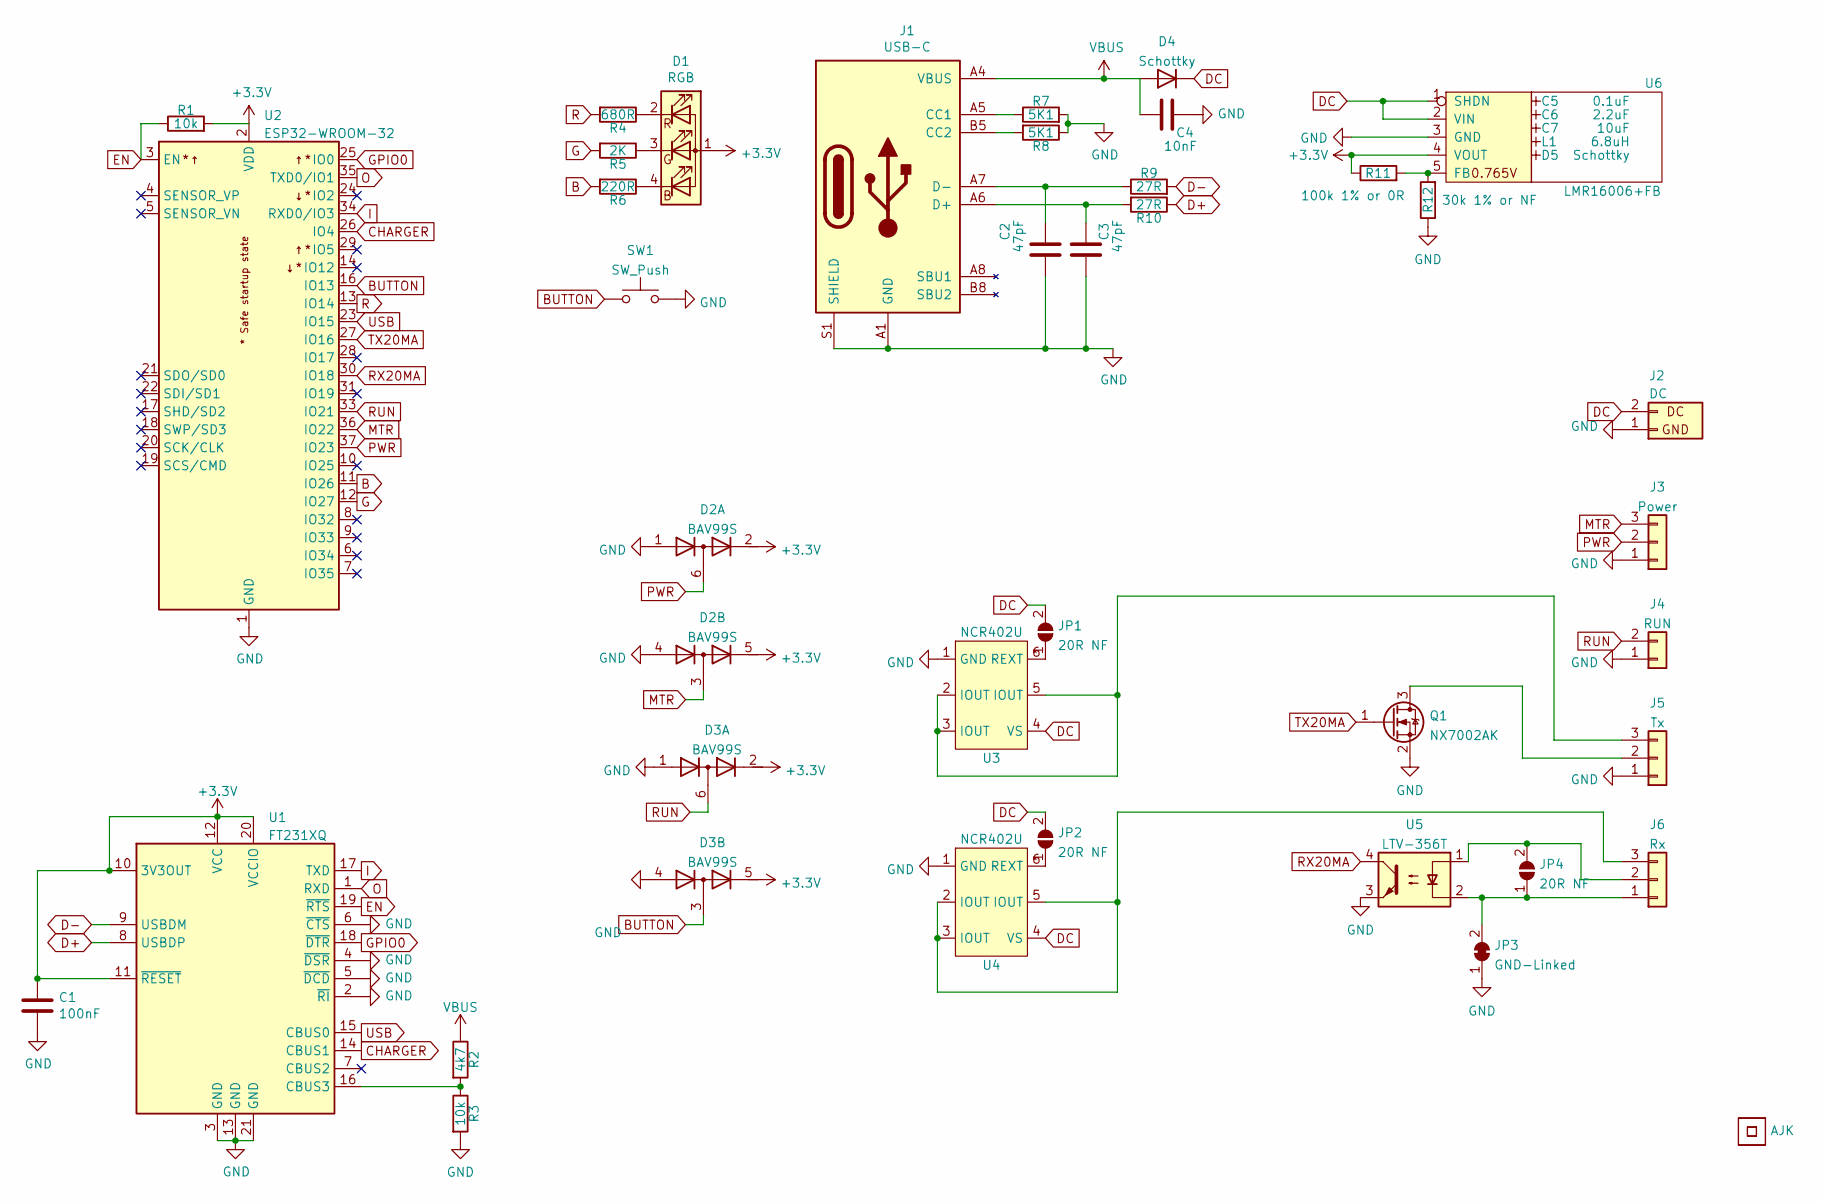
[picture p22: schematic ASR33Old.kicad_sch, ASR33 controller]

Parts:
C1: 100nF; C_0603
C2, C3: 47pF; C_0603
C4: 10nF; C_0603
C5: 0.1uF; Hidden
C6: 2.2uF; Hidden
C7: 10uF; Hidden
D1: RGB; LED-RGB-1.6x1.6; Part No APTF1616LSEEZGKQBKC
D2, D3: BAV99S; SOT-363_SC-70-6
D4: Schottky; D_1206_3216Metric
D5: Schottky; Hidden; Part No CD1206-B2100
J1: USB-C; USC16-TR-Round; Part No CSP-USC16-TR
J2: DC; Molex_MiniSPOX_H2RA
J3: Power; Molex_MiniSPOX_H3RA
J4: RUN; Molex_MiniSPOX_H2RA
J5: Tx; Molex_MiniSPOX_H3RA
J6: Rx; Molex_MiniSPOX_H3RA
JP1, JP2, JP4: 20R NF; Pad_1206_0805_Open
JP3: GND-Linked; Pad_1206_0805_Bridged
L1: 6.8uH; Hidden; Part No TYA4020
Logo1: AJK
Q1: NX7002AK; SOT-23
R1, R3: 10k; R_0603
R2: 4k7; R_0603
R4: 680R; R_0603
R5: 2K; R_0603
R6: 220R; R_0603
R7, R8: 5K1; R_0603
R9, R10: 27R; R_0603
R11: 100k 1% or 0R; R_0603
R12: 30k 1% or NF; R_0603
SW1: SW_Push; SW_PUSH_6mm_PTH
U1: FT231XQ; QFN-20-1EP_4x4mm_P0.5mm_EP2.5x2.5mm
U2: ESP32-WROOM-32
U3, U4: NCR402U; SOT-457
U5: LTV-356T; SO-4_4.4x3.6mm_P2.54mm
U6: LMR16006+FB; RegulatorBlockFB; Part No LMR16006YQ3
U7: QR; QR-ASR33

Connections:
+3V3: C1.1, D1.1 (A), D2.2 (K2), D2.5 (K4), D3.2 (K2), D3.5 (K4), R1.2, R11.1, U1.10 (3V3OUT), U1.11 (~RESET), U1.12 (VCC), U1.20 (VCCIO), U2.2 (VDD), U6.4 (VOUT)
B: R6.2, U2.11 (IO26)
BUTTON: D3.3 (K1A2), SW1.2, U2.16 (IO13)
CHARGER: U1.14 (CBUS1), U2.26 (IO4)
D+: R10.1, U1.8 (USBDP)
D-: R9.2, U1.9 (USBDM)
DC: D4.1 (K), J2.2 (DC), JP1.2 (B), JP2.2 (B), U3.4 (VS), U4.4 (VS), U6.1 (SHDN), U6.2 (VIN)
EN: R1.1, U1.19 (~RTS), U2.3 (EN)
G: R5.2, U2.12 (IO27)
GND: C1.2, C2.2, C3.2, C4.1, D2.1 (A1), D2.4 (A3), D3.1 (A1), D3.4 (A3), J1.A1 (GND), J1.A12 (GND), J1.B1 (GND), J1.B12 (GND), J1.S1 (SHIELD), J2.1 (GND), J3.1, J4.1, J5.1, JP3.1 (A), Q1.2 (S), R3.2, R7.2, R8.1, R12.1, SW1.1, U1.2 (~RI), U1.3 (GND), U1.4 (~DSR), U1.5 (~DCD), U1.6 (~CTS), U1.13 (GND), U1.21 (GND), U2.1 (GND), U2.15 (GND), U2.38 (GND), U2.39 (GND), U3.1 (GND), U4.1 (GND), U5.3, U6.3 (GND)
GPIO0: U1.18 (~DTR), U2.25 (IO0)
I: U1.17 (TXD), U2.34 (RXD0/IO3)
MTR: D2.3 (K1A2), J3.3, U2.36 (IO22)
unnamed: C2.1, J1.A7 (D-), J1.B7 (D-), R9.1
unnamed: C3.1, J1.A6 (D+), J1.B6 (D+), R10.2
unnamed: D1.2 (RK), R4.1
unnamed: D1.3 (GK), R5.1
unnamed: D1.4 (BK), R6.1
unnamed: J1.A5 (CC1), R7.1
unnamed: J1.B5 (CC2), R8.2
unnamed: J5.2, Q1.3 (D)
unnamed: J5.3, U3.2 (IOUT), U3.3 (IOUT), U3.5 (IOUT)
unnamed: J6.1, JP3.2 (B), JP4.1 (A), U5.2
unnamed: J6.2, JP4.2 (B), U5.1
unnamed: J6.3, U4.2 (IOUT), U4.3 (IOUT), U4.5 (IOUT)
unnamed: JP1.1 (A), U3.6 (REXT)
unnamed: JP2.1 (A), U4.6 (REXT)
unnamed: R2.2, R3.1, U1.16 (CBUS3)
unnamed: R11.2, R12.2, U6.5 (FB)
O: U1.1 (RXD), U2.35 (TXD0/IO1)
PWR: D2.6 (K3A4), J3.2, U2.37 (IO23)
R: R4.2, U2.13 (IO14)
RUN: D3.6 (K3A4), J4.2, U2.33 (IO21)
RX20MA: U2.30 (IO18), U5.4
TX20MA: Q1.1 (G), U2.27 (IO16)
USB: U1.15 (CBUS0), U2.23 (IO15)
VBUS: C4.2, D4.2 (A), J1.A4 (VBUS), J1.A9 (VBUS), J1.B4 (VBUS), J1.B9 (VBUS), R2.1

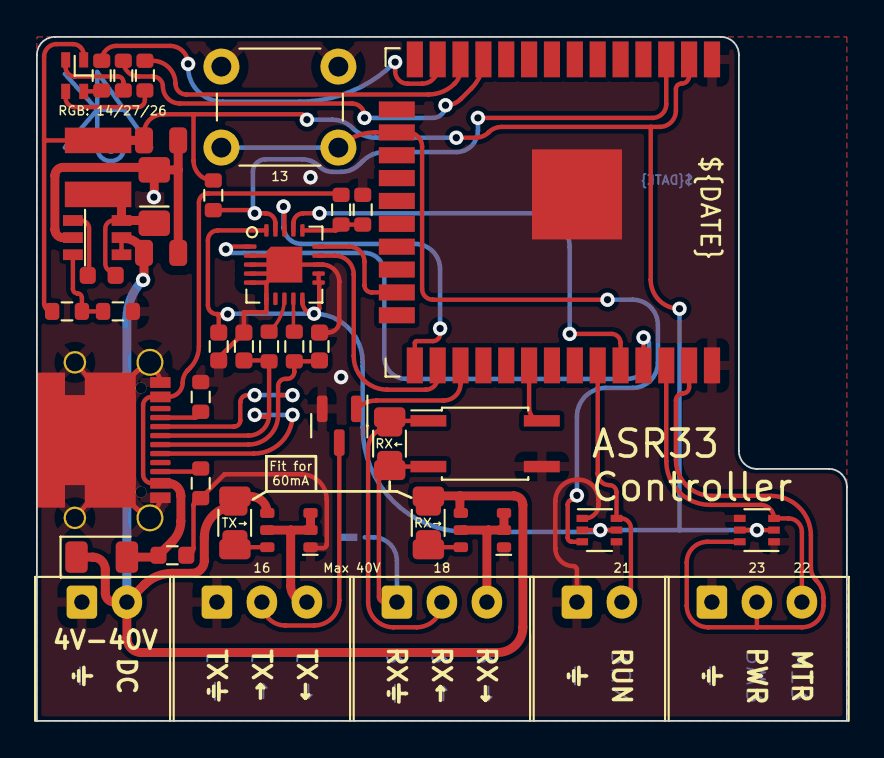
[picture p23: board ASR33Old.kicad_pcb from above]

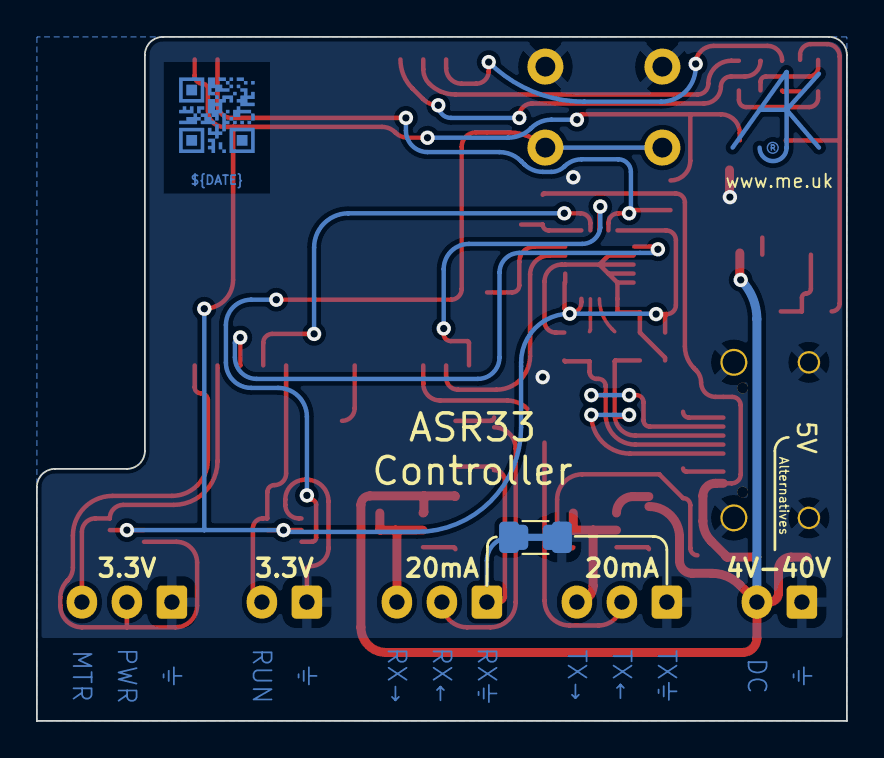
[picture p24: board ASR33Old.kicad_pcb from below]

Board: 2 copper layers, 45.0 x 38.0 mm, 45 parts (3 on the bottom side), 37 nets.
