revk/ESP32-ASR33/main/smallfont.h

['0'] = { 0x70, 0x88, 0x88, 0x70 },     //
['1'] = { 0x88, 0xF8, 0x80 },   //
['2'] = { 0xC8, 0xA8, 0xA8, 0x90 },     //
['3'] = { 0x88, 0xA8, 0xA8, 0x50 },     //
['4'] = { 0x60, 0x50, 0xF8, 0x40 },     //
['5'] = { 0xB8, 0xA8, 0xA8, 0X48 },     //
['6'] = { 0x70, 0xA8, 0xA8, 0x40 },     //
['7'] = { 0x08, 0xC8, 0x28, 0x18 },     //
['8'] = { 0x50, 0xA8, 0xA8, 0x50 },     //
['9'] = { 0x10, 0xA8, 0xA8, 0x70 },     //
['A'] = { 0xF0, 0x28, 0x28, 0xF0 },     //
['B'] = { 0xF8, 0xA8, 0xA8, 0x50 },     //
['C'] = { 0x70, 0x88, 0x88, 0x88 },     //
['D'] = { 0xF8, 0x88, 0x88, 0x70 },     //
['E'] = { 0xF8, 0xA8, 0xA8, 0x88 },     //
['F'] = { 0xF8, 0x28, 0x28, 0x08 },     //
['G'] = { 0x70, 0x88, 0xA8, 0x68 },     //
['H'] = { 0xF8, 0x20, 0x20, 0xF8 },     //
['I'] = { 0x88, 0xF8, 0x88 },   //
['J'] = { 0x40, 0x88, 0x78, 0x08 },     //
['K'] = { 0xF8, 0x20, 0x50, 0x88 },     //
['L'] = { 0xF8, 0x80, 0x80, 0x80 },     //
['M'] = { 0xF8, 0x10, 0x20, 0x10, 0xF8 },       //
['N'] = { 0xF8, 0x10, 0x20, 0xF8 },     //
['O'] = { 0x70, 0x88, 0x88, 0x70 },     //
['P'] = { 0xF8, 0x28, 0x28, 0x10 },     //
['Q'] = { 0x70, 0x88, 0xA8, 0x48, 0xB0 },       //
['R'] = { 0xF8, 0x28, 0x68, 0x90 },     //
['S'] = { 0x90, 0xA8, 0xA8, 0x48 },     //
['T'] = { 0x08, 0x08, 0xF8, 0x08, 0x08 },       //
['U'] = { 0x78, 0x80, 0x80, 0x78 },     //
['V'] = { 0x38, 0x40, 0x80, 0x40, 0x38 },       //
['W'] = { 0x78, 0x80, 0x60, 0x80, 0x78 },       //
['X'] = { 0x88, 0x50, 0x20, 0x50, 0x88 },       //
['Y'] = { 0x08, 0x10, 0xE0, 0x10, 0x08 },       //
['Z'] = { 0x88, 0xC8, 0xA8, 0x98, 0x88 },       //
['['] = { 0xF8, 0x88 },         //
[']'] = { 0x88, 0xF8 },         //
['('] = { 0x70, 0x88 },         //
[')'] = { 0x88, 0x70 },         //
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
