revk/ESP32-ASR33/(commit log)

2020-12-05 Auto power control via sonoff mqtt now
2020-12-05 Allow time to print
2020-12-05 Time to print
2020-12-06 Silly me - one has to CR before LF as CR takes too long and next char prints during flyback. D'Oh
    [ASR33.c]
2020-12-07 D'oh utf-8 not skipped
    [ASR33.c]
2020-12-07 Losing the plot here, silly mistake in UTF-8
    [ASR33.c]
2020-12-07 OK, time to go back to bed, try that!
2020-12-07 Flush rx during power up timer
2020-12-08 Separate motor control
2020-12-15 COrrect feed hole position
    [punch.c]
2020-12-19 Power up cleaner
2020-12-19 Tweaking power up sequence
2020-12-19 New asrtweet print
2020-12-19 full text and de-XML stuff
2020-12-20 Still some issues with tweets
    [ASR33.c, asrtweet.c]
2020-12-24 Additional GPIO for direct power control
2020-12-27 Tidy up a bit, and fix power bug
    [ASR33.c]
2020-12-27 Silly issue with mqtt
    [ASR33.c]
2020-12-27 manual on power switch
2021-01-01 Added answerback drum
    [HEREIS.scad]
2021-01-06 Fix broken wrapping when unicode chars
    [asrtweet.c]
2021-04-11 More options to invert pins
    [ASR33.c]
2021-04-11 Changed defaults to use the OTA board
2021-04-11 Use OTA board
2021-04-13 Tweaks for new OTA board
2021-04-13 Correct pin values
2021-09-10 Latest generic board
2022-01-23 New dedicated ASR33 PCB
    [ASR33-B_Cu.gbr, ASR33-B_Mask.gbr, ASR33-B_Paste.gbr, ASR33-B_Silkscreen.gbr, ASR33-Edge_Cuts.gbr, ASR33-F_Cu.gbr, ASR33-F_Mask.gbr, ASR33-F_Paste.gbr]
2022-01-24 New PCB
    [ASR33.kicad_sch]
2022-01-24 Tweak, added button
    [ASR33-B_Cu.gbr, ASR33-B_Mask.gbr, ASR33-B_Paste.gbr, ASR33-B_Silkscreen.gbr, ASR33-Edge_Cuts.gbr, ASR33-F_Cu.gbr, ASR33-F_Mask.gbr, ASR33-F_Paste.gbr]
2022-01-24 Tweaked PCB
2022-01-24 Correct pos for regulator
    [ASR33-B_Cu.gbr, ASR33-B_Mask.gbr, ASR33-B_Paste.gbr, ASR33-B_Silkscreen.gbr, ASR33-Edge_Cuts.gbr, ASR33-F_Cu.gbr, ASR33-F_Mask.gbr, ASR33-F_Paste.gbr]
2022-01-26 Gold lettering
    [ASR33-B_Cu.gbr, ASR33-B_Mask.gbr, ASR33-B_Paste.gbr, ASR33-B_Silkscreen.gbr, ASR33-Edge_Cuts.gbr, ASR33-F_Cu.gbr, ASR33-F_Mask.gbr, ASR33-F_Paste.gbr]
2022-01-27 Tidy GPIO naming and invert logic
    [ASR33.c]
2022-01-28 Reworkd tx/rx
    [ASR33-B_Cu.gbr, ASR33-B_Mask.gbr, ASR33-B_Paste.gbr, ASR33-B_Silkscreen.gbr, ASR33-Edge_Cuts.gbr, ASR33-F_Cu.gbr, ASR33-F_Mask.gbr, ASR33-F_Paste.gbr]
2022-01-28 Reworked PCB and manuals
    [ASR33-B_Cu.gbr, ASR33-B_Mask.gbr, ASR33-B_Paste.gbr, ASR33-B_Silkscreen.gbr, ASR33-Edge_Cuts.gbr, ASR33-F_Cu.gbr, ASR33-F_Mask.gbr, ASR33-F_Paste.gbr]
2022-01-28 Added network on Tx, same as FS-2 send circuit.
    [ASR33-B_Cu.gbr, ASR33-B_Mask.gbr, ASR33-B_Paste.gbr, ASR33-B_Silkscreen.gbr, ASR33-Edge_Cuts.gbr, ASR33-F_Cu.gbr, ASR33-F_Mask.gbr, ASR33-F_Paste.gbr]
2022-01-29 Complete re-work with more connectors.
    [ASR33-B_Cu.gbr, ASR33-B_Mask.gbr, ASR33-B_Paste.gbr, ASR33-B_Silkscreen.gbr, ASR33-Edge_Cuts.gbr, ASR33-F_Cu.gbr, ASR33-F_Mask.gbr, ASR33-F_Paste.gbr]
2022-01-29 Read for when 3D case works again
    [ASR33.scad, ASR33.stl]
2022-01-29 More tinkering
    [ASR33-B_Cu.gbr, ASR33-B_Mask.gbr, ASR33-B_Paste.gbr, ASR33-B_Silkscreen.gbr, ASR33-Edge_Cuts.gbr, ASR33-F_Cu.gbr, ASR33-F_Mask.gbr, ASR33-F_Paste.gbr]
2022-01-29 Fix resistor values on LED
    [ASR33-B_Cu.gbr, ASR33-B_Mask.gbr, ASR33-B_Paste.gbr, ASR33-B_Silkscreen.gbr, ASR33-Edge_Cuts.gbr, ASR33-F_Cu.gbr, ASR33-F_Mask.gbr, ASR33-F_Paste.gbr]
2022-01-29 Round corners
    [ASR33-B_Cu.gbr, ASR33-B_Mask.gbr, ASR33-B_Paste.gbr, ASR33-B_Silkscreen.gbr, ASR33-Edge_Cuts.gbr, ASR33-F_Cu.gbr, ASR33-F_Mask.gbr, ASR33-F_Paste.gbr]
2022-01-30 Label GPIOs on silkscreen
    [ASR33-B_Cu.gbr, ASR33-B_Mask.gbr, ASR33-B_Paste.gbr, ASR33-B_Silkscreen.gbr, ASR33-Edge_Cuts.gbr, ASR33-F_Cu.gbr, ASR33-F_Mask.gbr, ASR33-F_Paste.gbr]
2022-01-30 More on 60mA
    [ASR33-B_Cu.gbr, ASR33-B_Mask.gbr, ASR33-B_Paste.gbr, ASR33-B_Silkscreen.gbr, ASR33-Edge_Cuts.gbr, ASR33-F_Cu.gbr, ASR33-F_Mask.gbr, ASR33-F_Paste.gbr]
2022-01-30 Tidy silk screen
    [ASR33-B_Cu.gbr, ASR33-B_Mask.gbr, ASR33-B_Paste.gbr, ASR33-B_Silkscreen.gbr, ASR33-Edge_Cuts.gbr, ASR33-F_Cu.gbr, ASR33-F_Mask.gbr, ASR33-F_Paste.gbr]
2022-01-30 Better 60mA documentaion
    [ASR33-B_Cu.gbr, ASR33-B_Mask.gbr, ASR33-B_Paste.gbr, ASR33-B_Silkscreen.gbr, ASR33-Edge_Cuts.gbr, ASR33-F_Cu.gbr, ASR33-F_Mask.gbr, ASR33-F_Paste.gbr]
2022-01-30 Document voltages
    [ASR33-B_Cu.gbr, ASR33-B_Mask.gbr, ASR33-B_Paste.gbr, ASR33-B_Silkscreen.gbr, ASR33-Edge_Cuts.gbr, ASR33-F_Cu.gbr, ASR33-F_Mask.gbr, ASR33-F_Paste.gbr]
2022-01-30 Tweak tracks
    [ASR33-B_Cu.gbr, ASR33-B_Mask.gbr, ASR33-B_Paste.gbr, ASR33-B_Silkscreen.gbr, ASR33-Edge_Cuts.gbr, ASR33-F_Cu.gbr, ASR33-F_Mask.gbr, ASR33-F_Paste.gbr]
2022-01-31 Library update
    [ASR33.kicad_pcb, ASR33.scad]
2022-01-31 Started on 3D case
    [ASR33.scad]
2022-01-31 Min 110
    [ASR33.scad]
2022-01-31 Started on 3D
    [ASR33.scad, ASR33.stl]
2022-01-31 Clarify voltages and 60mA working
2022-02-01 Starting code for soft uart
2022-02-01 Started on soft uart code
2022-02-01 Started soft uart option
2022-02-01 Soft UART Tx seems to be working
2022-02-01 Soft UART Rx
2022-02-01 Soft UART working well including break send and detect
2022-02-01 Updated for new soft UART options
2022-02-05 Close TCP on power off and on BREAK
2022-02-05 Changed defaults for new board
2022-02-05 TCP socket is raw to teletype
2022-02-06 Reworked power control a lot
    [ASR33.c, softuart.c, softuart.h, tty.c, tty.h]
2022-02-07 BOM fix
    [ASR33.csv, ASR33.kicad_pcb, ASR33.kicad_sch]
2022-02-08 Various tidy of soft uart
2022-02-08 Power for break
2022-02-08 Startd on LED and autoconnect
2022-02-08 More LED
2022-02-08 3D case initial try
    [ASR33.scad, ASR33.stl]
2022-02-08 Tidy up for sending files
    [ASR33.scad]
2022-02-08 New 3D cases
    [ASR33.stl, ASR33h.scad, ASR33h.stl]
2022-02-09 line was missing spaces
    [ASR33.c]
2022-02-09 Buggered up the tx
    [softuart.c]
2022-02-20 Corrected VBUS/DC working, and moved some GPIO to avoid problematic startup strapping.
    [ASR33-B_Cu.gbr, ASR33-B_Mask.gbr, ASR33-B_Paste.gbr, ASR33-B_Silkscreen.gbr, ASR33-Edge_Cuts.gbr, ASR33-F_Cu.gbr, ASR33-F_Mask.gbr, ASR33-F_Paste.gbr]
2022-02-22 FFS, missed 3.3V to FT231XQ
    [ASR33-B_Cu.gbr, ASR33-B_Mask.gbr, ASR33-B_Paste.gbr, ASR33-B_Silkscreen.gbr, ASR33-Edge_Cuts.gbr, ASR33-F_Cu.gbr, ASR33-F_Mask.gbr, ASR33-F_Paste.gbr]
2022-02-23 Old ESP32-WROOM-32 based
    [ASR33Old.kicad_pcb, ASR33Old.kicad_sch]
2022-02-23 New PICO version
    [ASR33-B_Cu.gbr, ASR33-B_Mask.gbr, ASR33-B_Paste.gbr, ASR33-B_Silkscreen.gbr, ASR33-Edge_Cuts.gbr, ASR33-F_Cu.gbr, ASR33-F_Mask.gbr, ASR33-F_Paste.gbr]
2022-02-23 New board
2022-02-23 Reinstated the GND link
    [ASR33-B_Cu.gbr, ASR33-B_Mask.gbr, ASR33-B_Paste.gbr, ASR33-B_Silkscreen.gbr, ASR33-Edge_Cuts.gbr, ASR33-F_Cu.gbr, ASR33-F_Mask.gbr, ASR33-F_Paste.gbr]
2022-02-23 Tidy up
    [ASR33-B_Cu.gbr, ASR33-B_Mask.gbr, ASR33-B_Paste.gbr, ASR33-B_Silkscreen.gbr, ASR33-Edge_Cuts.gbr, ASR33-F_Cu.gbr, ASR33-F_Mask.gbr, ASR33-F_Paste.gbr]
2022-02-24 Very minor tweak
    [ASR33-B_Cu.gbr, ASR33-B_Mask.gbr, ASR33-B_Paste.gbr, ASR33-B_Silkscreen.gbr, ASR33-Edge_Cuts.gbr, ASR33-F_Cu.gbr, ASR33-F_Mask.gbr, ASR33-F_Paste.gbr]
2022-02-24 Tidy schematic
    [ASR33Old.kicad_pcb, ASR33Old.kicad_sch]
2022-03-11 Tidy 3D
    [ASR33.scad, ASR33h.scad]
2022-06-23 Tweak PCB layout
    [ASR33-B_Cu.gbr, ASR33-B_Mask.gbr, ASR33-B_Paste.gbr, ASR33-B_Silkscreen.gbr, ASR33-Edge_Cuts.gbr, ASR33-F_Cu.gbr, ASR33-F_Mask.gbr, ASR33-F_Paste.gbr]
2022-12-31 v5.0 timer
    [ASR33.scad]
2023-03-27 New Manuals in markdown and new PCB connectos
    [ASR33-B_Cu.gbr, ASR33-B_Mask.gbr, ASR33-B_Paste.gbr, ASR33-B_Silkscreen.gbr, ASR33-Edge_Cuts.gbr, ASR33-F_Cu.gbr, ASR33-F_Mask.gbr, ASR33-F_Paste.gbr]
2023-03-27 Updated STL
    [ASR33.scad, ASR33.stl, ASR33h.scad, ASR33h.stl]
2023-06-11 Production files
    [ASR33.kicad_pcb, ASR33.kicad_sch, bom.csv, designators.csv, positions.csv]
2023-06-11 Added programming header for when not using USB data
    [ASR33.kicad_pcb, ASR33.kicad_sch, bom.csv, designators.csv, positions.csv]
2023-06-11 Rework for 5 pin header instead of USB/USART
    [ASR33.kicad_pcb, ASR33.kicad_sch, bom.csv, designators.csv, positions.csv]
2023-06-12 Purchase link
    [ASR33.kicad_pcb]
2023-06-15 Prog header
    [ASR33.kicad_pcb]
2023-06-18 Tidy silk
    [ASR33.kicad_pcb, ASR33.kicad_sch]
2023-08-13 New layout with S3
    [ASR33.kicad_pcb, ASR33.kicad_sch, bom.csv, designators.csv, positions.csv]
2024-01-26 Clean up PCB
    [ASR33.kicad_pcb, ASR33.kicad_sch, bom.csv, designators.csv, positions.csv]
2024-03-17 Pos file
    [ASR33.kicad_pcb, positions.csv]
2024-08-03 Update for ESP32 and latest boards with WS2812 LED
2024-08-25 Clean up rx soft uart slightly
2025-01-13 New images
    [ASR33.kicad_pcb, ASR33.scad, ASR33h.scad, ASR33h.stl]
2025-01-19 Footprint update
    [ASR33.kicad_pcb, positions.csv]
2025-01-23 PCB Update
    [ASR33.kicad_pcb, ASR33.kicad_sch]
2025-01-31 Image and new tc2030
    [ASR33.kicad_pcb, ASR33.kicad_sch]
2025-09-20 New casework
    [ASR33.kicad_pcb, ASR33.scad, ASR33.stl, ASR33B.scad, ASR33B.stl, ASR33T.scad, ASR33T.stl, positions.csv]
